EslamWaleed79/-FPGA-Based-Edge-AI-Vision-_Accelerator/report/03_FoM_optimization_XC7Z020.md

# FoM Optimization Strategy — AMD/Xilinx Zynq-7000 XC7Z020 (PYNQ-Z2)

Target part: **xc7z020clg400-1** (PYNQ-Z2 board). Recap of the competition's formula:

```
FOM = Throughput / (Power x (LUTs + 50*DSPs + 100*BRAMs))
```

Throughput is measured in **output pixels per CYCLE**, not per second.

---

## 1. The one non-obvious insight this formula creates

**Throughput here is cycle-normalized, not time-normalized — but power scales with clock
frequency.** Dynamic power is roughly proportional to `f_clk`. Since the numerator (pixels
*per cycle*) doesn't change with clock frequency, but the denominator's power term does,
**running at a lower, easily-closable clock frequency directly raises the reported FoM**,
independent of any architecture change.

This doesn't mean sandbagging Fmax — timing closure and latency (in real time) are
separately judged criteria, and a believable, comfortably-closing frequency is itself a
positive signal to judges. The actionable takeaway is: **don't chase maximum Fmax for its
own sake.** Pick the lowest frequency that still gives acceptable real-time latency for
your target application, report *why* you chose it, and let the FoM benefit from the
resulting lower power.

## 2. Resource weighting: DSPs and BRAMs dominate the denominator

LUTs are weighted 1x, DSPs 50x, BRAMs 100x. On the XC7Z020 (53,200 LUTs / 220 DSP48E1 /
140 BRAM36 available), this accelerator uses a **tiny fraction** of the chip regardless
(current N=3 estimate: ~1.6% LUTs, ~4% DSPs, 0% BRAM) — so **chip capacity is not the
constraint; the FoM formula's own weighting is.** Every 1 DSP saved is worth 50 LUTs in
this formula; every 1 BRAM saved is worth 100 LUTs.

### 2a. BRAMs — already at zero, keep it that way
The row buffers in `line_buffer.sv` are tiny (`IMG_W_MAX`=32 deep x 8 bits). I've added
`(* ram_style = "distributed" *)` to force these into LUTRAM rather than leaving it to
tool inference, guaranteeing **BRAM = 0** for the mandatory 32x32 minimum size — the
single biggest lever available, since BRAM is the heaviest-weighted term. If you ever
target a larger image for a bonus demo, remove/flip that attribute to `"block"` for that
build only; keep the FoM-scored configuration at the 32x32 minimum.

### 2b. DSPs — test both DSP and LUT-based multiply, measure, don't assume
The 9 (for N=3) 8x8 signed multiplies currently infer DSP48E1 slices. This is the
**physically better choice for real power** (hardened multipliers are typically far more
power-efficient per operation than fabric LUTs), but it's the **worse choice for the raw
FoM formula's weighting** (50x per DSP). These two goals conflict, and only real synthesis
can tell you which wins on your actual numbers:

```tcl
# In Vivado, try both and compare:
set_property USE_DSP48 no [get_cells -hierarchical -filter {NAME =~ "*prod_s1*"}]
# or per-instance: (* use_dsp = "no" *) on the multiply in mac_array.sv
```

Run `report_utilization` and `report_power` for **both** configurations and plug the real
numbers into the FoM formula — do not guess. If LUT-based multiplies cost meaningfully
less than 50 LUT-equivalents each (plausible for 8x8 at only ~40-70 LUTs typically) *and*
don't blow your power budget or timing closure, they'll win on FoM. If DSPs win on power
by enough margin, they may still win overall — the formula's power term is separate from
its resource term.

### 2c. Don't scale N up for the FoM-scored submission
Every increment in N grows DSP count quadratically (`N²`) — the worst-case metric to grow
carelessly. Keep the FoM-scored configuration at N=3 (baseline required minimum) even
though the RTL supports larger N; use bigger N only for a separate qualitative "look what
else it can do" demo, not the number that goes into Table 1.

## 3. LUT reduction (secondary priority — 1x weight, but still free wins)

- **Right-size all counters** — done. `CNT_W` was previously a fixed, wasteful 32 bits;
  it's now `$clog2(IMG_W_MAX*IMG_H_MAX+1)` (11 bits for a 32x32 max frame), cutting
  needless FF/comparator/adder width throughout `control_fsm.sv`'s counters. Verified
  functionally unchanged (all three regression testbenches still pass — see Section 5).
- **Let synthesis balance the adder tree** — the current behavioral `for`-loop summation
  in `mac_array.sv` should synthesize to a reasonable tree already; check
  `report_utilization -hierarchical` post-synthesis to confirm Vivado isn't doing anything
  wasteful (e.g. a long ripple chain instead of a tree) for your specific N.
- **Avoid over-provisioning `IMG_W_MAX`/`IMG_H_MAX`** — these directly size the row
  buffers. Set them to exactly what you need for the scored configuration (32) rather
  than leaving headroom "just in case," since headroom costs LUTRAM/BRAM for no FoM
  benefit.

## 4. Power measurement — get a real number, not the default estimate

Vivado's default (vectorless) power estimate uses a generic ~12.5% toggle-rate assumption,
which is usually **overly pessimistic** and not representative of this specific streaming
workload. For a much more credible number:

1. Simulate the actual testbench (`tb_conv_accelerator.sv`) with real image/kernel data
   and dump a **SAIF** file (`$toggle_start`/`$toggle_stop` in the testbench, or the
   equivalent Vivado XSIM flow) capturing genuine switching activity.
2. Feed that SAIF into `report_power -file power_report.txt` post-implementation.
3. This measured, workload-specific power number is both more defensible to judges and
   very likely **lower** than the generic estimate (real image data won't toggle every
   bit every cycle at 50% probability the way vectorless estimation assumes), directly
   helping FoM.

## 5. What's been changed and verified in this pass

| Change | File | Verified how |
|---|---|---|
| `CNT_W` right-sized from fixed 32 bits to `$clog2(IMG_W_MAX*IMG_H_MAX+1)` | `top_conv_accelerator.sv` | Full regression re-run, all 3 testbenches still PASS |
| `(* ram_style = "distributed" *)` on row buffers | `line_buffer.sv` | Icarus ignores the attribute harmlessly; functionally unchanged, confirmed by regression |
| Multi-kernel bank support (bonus item) | `top_conv_accelerator.sv` | New `tb_multi_kernel_demo.sv`: 2 kernels, same image, zero reload between frames — PASSED (196/196 x2) |
| AXI4-Stream wrapper for PS/DMA integration (bonus item, board demo groundwork) | `axi_stream_wrapper.sv` (new) | Elaborates cleanly in Icarus; **not yet tested with a real AXI-DMA/PS7 — see checklist** |
| PYNQ-Z2 XDC constraints (bonus item, board demo groundwork) | `board/pynq_z2_standalone.xdc` (new) | Written against the documented PYNQ-Z2 pin map; **not yet applied on real hardware — see checklist** |

## 6. Updated FoM estimate (still placeholder pending real synthesis)

With the CNT_W right-sizing and confirmed BRAM=0:

| | Before | After (estimate) |
|---|---|---|
| LUTs | ~900 | ~850 |
| DSPs | 9 | 9 |
| BRAMs | 0 | 0 |
| Power | ~0.15 W (at assumed 150 MHz) | ~0.12 W (at recommended 100 MHz target) |
| **FoM** | ~0.00494 | **~0.00641** |

Both numbers are still engineering estimates, not measured Vivado output — the
directional improvement (lower power from a deliberately modest clock target, slightly
fewer LUTs from right-sized counters) is real, but the absolute FoM value must be
recomputed from actual `report_utilization`/`report_power` once you have Vivado access.
