EslamWaleed79/-FPGA-Based-Edge-AI-Vision-_Accelerator/Vivado_____Files/Run1/project_3.runs/design_1_axi_dma_0_0_synth_1/.vivado.begin.rst

<?xml version="1.0"?>
<ProcessHandle Version="1" Minor="0">
    <Process Command="vivado.bat" Owner="compumarts" Host="DESKTOP-1IDCUPR" Pid="28528">
    </Process>
</ProcessHandle>
