EslamWaleed79/-FPGA-Based-Edge-AI-Vision-_Accelerator/Vivado_____Files/Run1/project_3.runs/impl_1/.init_design.begin.rst

<?xml version="1.0"?>
<ProcessHandle Version="1" Minor="0">
    <Process Command=".planAhead." Owner="compumarts" Host="DESKTOP-1IDCUPR" Pid="28092">
    </Process>
</ProcessHandle>
