EslamWaleed79/-FPGA-Based-Edge-AI-Vision-_Accelerator/Vivado_Reports/post_route_power_report.txt

Copyright 1986-2018 Xilinx, Inc. All Rights Reserved.
----------------------------------------------------------------------------------------
| Tool Version     : Vivado v.2018.2 (win64) Build 2258646 Thu Jun 14 20:03:12 MDT 2018
| Date             : Wed Sep  9 02:31:31 2026
| Host             : DESKTOP-1IDCUPR running 64-bit major release  (build 9200)
| Command          : report_power -file post_route_power_report.txt
| Design           : top_conv_accelerator
| Device           : xc7z020clg400-1
| Design State     : routed
| Grade            : commercial
| Process          : typical
| Characterization : Production
----------------------------------------------------------------------------------------

Power Report

Table of Contents
-----------------
1. Summary
1.1 On-Chip Components
1.2 Power Supply Summary
1.3 Confidence Level
2. Settings
2.1 Environment
2.2 Clock Constraints
3. Detailed Reports
3.1 By Hierarchy

1. Summary
----------

+--------------------------+----------------------------------------------------------------------------------------------+
| Total On-Chip Power (W)  | 0.125                                                                                        |
| Design Power Budget (W)  | Unspecified*                                                                                 |
| Power Budget Margin (W)  | NA                                                                                           |
| Dynamic (W)              | 0.020                                                                                        |
| Device Static (W)        | 0.105                                                                                        |
| Effective TJA (C/W)      | 11.5                                                                                         |
| Max Ambient (C)          | 83.6                                                                                         |
| Junction Temperature (C) | 26.4                                                                                         |
| Confidence Level         | Medium                                                                                       |
| Setting File             | ---                                                                                          |
| Simulation Activity File | C:/Users/compumarts/Desktop/project_2/project_2.sim/sim_1/impl/func/xsim/activity_final.saif |
| Design Nets Matched      | 2%   (64/3500)                                                                               |
+--------------------------+----------------------------------------------------------------------------------------------+
* Specify Design Power Budget using, set_operating_conditions -design_power_budget <value in Watts>

1.1 On-Chip Components
----------------------

+-------------------------+-----------+----------+-----------+-----------------+
| On-Chip                 | Power (W) | Used     | Available | Utilization (%) |
+-------------------------+-----------+----------+-----------+-----------------+
| Clocks                  |     0.003 |        3 |       --- |             --- |
| Slice Logic             |     0.005 |     2929 |       --- |             --- |
|   LUT as Logic          |     0.004 |     1231 |     53200 |            2.31 |
|   CARRY4                |    <0.001 |      154 |     13300 |            1.16 |
|   Register              |    <0.001 |     1106 |    106400 |            1.04 |
|   F7/F8 Muxes           |    <0.001 |       64 |     53200 |            0.12 |
|   LUT as Shift Register |    <0.001 |        1 |     17400 |           <0.01 |
|   Others                |     0.000 |        9 |       --- |             --- |
| Signals                 |     0.005 |     2482 |       --- |             --- |
| I/O                     |     0.007 |       62 |       125 |           49.60 |
| Static Power            |     0.105 |          |           |                 |
| Total                   |     0.125 |          |           |                 |
+-------------------------+-----------+----------+-----------+-----------------+

1.2 Power Supply Summary
------------------------

+-----------+-------------+-----------+-------------+------------+
| Source    | Voltage (V) | Total (A) | Dynamic (A) | Static (A) |
+-----------+-------------+-----------+-------------+------------+
| Vccint    |       1.000 |     0.020 |       0.013 |      0.007 |
| Vccaux    |       1.800 |     0.011 |       0.001 |      0.010 |
| Vcco33    |       3.300 |     0.000 |       0.000 |      0.000 |
| Vcco25    |       2.500 |     0.000 |       0.000 |      0.000 |
| Vcco18    |       1.800 |     0.004 |       0.003 |      0.001 |
| Vcco15    |       1.500 |     0.000 |       0.000 |      0.000 |
| Vcco135   |       1.350 |     0.000 |       0.000 |      0.000 |
| Vcco12    |       1.200 |     0.000 |       0.000 |      0.000 |
| Vccaux_io |       1.800 |     0.000 |       0.000 |      0.000 |
| Vccbram   |       1.000 |     0.000 |       0.000 |      0.000 |
| MGTAVcc   |       1.000 |     0.000 |       0.000 |      0.000 |
| MGTAVtt   |       1.200 |     0.000 |       0.000 |      0.000 |
| MGTVccaux |       1.800 |     0.000 |       0.000 |      0.000 |
| Vccpint   |       1.000 |     0.016 |       0.000 |      0.016 |
| Vccpaux   |       1.800 |     0.010 |       0.000 |      0.010 |
| Vccpll    |       1.800 |     0.003 |       0.000 |      0.003 |
| Vcco_ddr  |       1.500 |     0.000 |       0.000 |      0.000 |
| Vcco_mio0 |       1.800 |     0.000 |       0.000 |      0.000 |
| Vcco_mio1 |       1.800 |     0.000 |       0.000 |      0.000 |
| Vccadc    |       1.800 |     0.020 |       0.000 |      0.020 |
+-----------+-------------+-----------+-------------+------------+

1.3 Confidence Level
--------------------

+-----------------------------+------------+------------------------------------------------+------------------------------------------------------------------------------------------------------------+
| User Input Data             | Confidence | Details                                        | Action                                                                                                     |
+-----------------------------+------------+------------------------------------------------+------------------------------------------------------------------------------------------------------------+
| Design implementation state | High       | Design is routed                               |                                                                                                            |
| Clock nodes activity        | High       | User specified more than 95% of clocks         |                                                                                                            |
| I/O nodes activity          | High       | User specified more than 95% of inputs         |                                                                                                            |
| Internal nodes activity     | Medium     | User specified less than 25% of internal nodes | Provide missing internal nodes activity with simulation results or by editing the "By Resource Type" views |
| Device models               | High       | Device models are Production                   |                                                                                                            |
|                             |            |                                                |                                                                                                            |
| Overall confidence level    | Medium     |                                                |                                                                                                            |
+-----------------------------+------------+------------------------------------------------+------------------------------------------------------------------------------------------------------------+

2. Settings
-----------

2.1 Environment
---------------

+-----------------------+------------------------+
| Ambient Temp (C)      | 25.0                   |
| ThetaJA (C/W)         | 11.5                   |
| Airflow (LFM)         | 250                    |
| Heat Sink             | none                   |
| ThetaSA (C/W)         | 0.0                    |
| Board Selection       | medium (10"x10")       |
| # of Board Layers     | 8to11 (8 to 11 Layers) |
| Board Temperature (C) | 25.0                   |
+-----------------------+------------------------+

2.2 Clock Constraints
---------------------

+-------+--------+-----------------+
| Clock | Domain | Constraint (ns) |
+-------+--------+-----------------+
| clk   | clk    |            15.0 |
+-------+--------+-----------------+

3. Detailed Reports
-------------------

3.1 By Hierarchy
----------------

+----------------------+-----------+
| Name                 | Power (W) |
+----------------------+-----------+
| top_conv_accelerator |     0.020 |
|   u_fsm              |    <0.001 |
|   u_line_buffer      |     0.005 |
|   u_mac_array        |     0.006 |
|     u_relu           |    <0.001 |
+----------------------+-----------+
