EslamWaleed79/-FPGA-Based-Edge-AI-Vision-_Accelerator/edge_demo/edge_detection_result.png

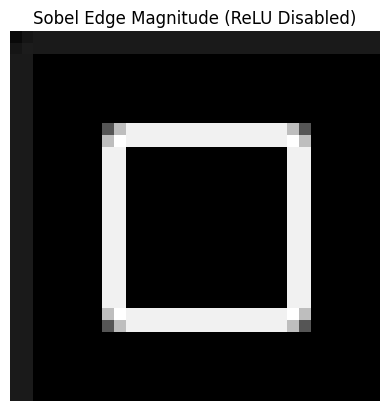
edge_demo/edge_detection_result.png
