EslamWaleed79/-FPGA-Based-Edge-AI-Vision-_Accelerator/FPGA Demo Files/test.jpg

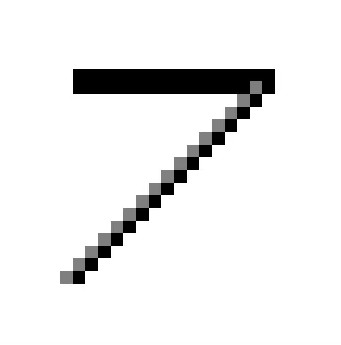
FPGA Demo Files/test.jpg
