EslamWaleed79/-FPGA-Based-Edge-AI-Vision-_Accelerator/Vivado_____Files/Run1/project_3.runs/design_1_axi_smc_0_synth_1/.Xil/design_1_axi_smc_0_propImpl.xdc

set_property SRC_FILE_INFO {cfile:C:/Xilinx/Vivado/2018.2/data/ip/xpm/xpm_memory/tcl/xpm_memory_xdc.tcl rfile:../../../../../../../Xilinx/Vivado/2018.2/data/ip/xpm/xpm_memory/tcl/xpm_memory_xdc.tcl id:1 order:LATE scoped_inst:{inst/m00_nodes/m00_ar_node/inst/inst_mi_handler/gen_normal_area.gen_node_prog_full.inst_node_prog_full/gen_xpm_memory_fifo.inst_fifo/gen_mem_rep[0].inst_xpm_memory} unmanaged:yes} [current_design]
set_property SRC_FILE_INFO {cfile:C:/Xilinx/Vivado/2018.2/data/ip/xpm/xpm_memory/tcl/xpm_memory_xdc.tcl rfile:../../../../../../../Xilinx/Vivado/2018.2/data/ip/xpm/xpm_memory/tcl/xpm_memory_xdc.tcl id:2 order:LATE scoped_inst:{inst/m00_nodes/m00_aw_node/inst/inst_mi_handler/gen_normal_area.gen_node_prog_full.inst_node_prog_full/gen_xpm_memory_fifo.inst_fifo/gen_mem_rep[0].inst_xpm_memory} unmanaged:yes} [current_design]
set_property SRC_FILE_INFO {cfile:C:/Xilinx/Vivado/2018.2/data/ip/xpm/xpm_memory/tcl/xpm_memory_xdc.tcl rfile:../../../../../../../Xilinx/Vivado/2018.2/data/ip/xpm/xpm_memory/tcl/xpm_memory_xdc.tcl id:3 order:LATE scoped_inst:{inst/m00_nodes/m00_w_node/inst/inst_mi_handler/gen_normal_area.gen_node_prog_full.inst_node_prog_full/gen_xpm_memory_fifo.inst_fifo/gen_mem_rep[0].inst_xpm_memory} unmanaged:yes} [current_design]
set_property SRC_FILE_INFO {cfile:C:/Xilinx/Vivado/2018.2/data/ip/xpm/xpm_memory/tcl/xpm_memory_xdc.tcl rfile:../../../../../../../Xilinx/Vivado/2018.2/data/ip/xpm/xpm_memory/tcl/xpm_memory_xdc.tcl id:4 order:LATE scoped_inst:{inst/s00_nodes/s00_r_node/inst/inst_mi_handler/gen_normal_area.gen_node_prog_full.inst_node_prog_full/gen_xpm_memory_fifo.inst_fifo/gen_mem_rep[0].inst_xpm_memory} unmanaged:yes} [current_design]
set_property SRC_FILE_INFO {cfile:C:/Xilinx/Vivado/2018.2/data/ip/xpm/xpm_memory/tcl/xpm_memory_xdc.tcl rfile:../../../../../../../Xilinx/Vivado/2018.2/data/ip/xpm/xpm_memory/tcl/xpm_memory_xdc.tcl id:5 order:LATE scoped_inst:{inst/s01_nodes/s01_b_node/inst/inst_mi_handler/gen_normal_area.gen_node_prog_full.inst_node_prog_full/gen_xpm_memory_fifo.inst_fifo/gen_mem_rep[0].inst_xpm_memory} unmanaged:yes} [current_design]
set_property SRC_FILE_INFO {cfile:C:/Xilinx/Vivado/2018.2/data/ip/xpm/xpm_memory/tcl/xpm_memory_xdc.tcl rfile:../../../../../../../Xilinx/Vivado/2018.2/data/ip/xpm/xpm_memory/tcl/xpm_memory_xdc.tcl id:6 order:LATE scoped_inst:{inst/m00_nodes/m00_ar_node/inst/inst_mi_handler/gen_normal_area.inst_fifo_node_payld/gen_xpm_memory_fifo.inst_fifo/gen_mem_rep[0].inst_xpm_memory} unmanaged:yes} [current_design]
set_property SRC_FILE_INFO {cfile:C:/Xilinx/Vivado/2018.2/data/ip/xpm/xpm_memory/tcl/xpm_memory_xdc.tcl rfile:../../../../../../../Xilinx/Vivado/2018.2/data/ip/xpm/xpm_memory/tcl/xpm_memory_xdc.tcl id:7 order:LATE scoped_inst:{inst/m00_nodes/m00_aw_node/inst/inst_mi_handler/gen_normal_area.inst_fifo_node_payld/gen_xpm_memory_fifo.inst_fifo/gen_mem_rep[0].inst_xpm_memory} unmanaged:yes} [current_design]
set_property SRC_FILE_INFO {cfile:C:/Xilinx/Vivado/2018.2/data/ip/xpm/xpm_memory/tcl/xpm_memory_xdc.tcl rfile:../../../../../../../Xilinx/Vivado/2018.2/data/ip/xpm/xpm_memory/tcl/xpm_memory_xdc.tcl id:8 order:LATE scoped_inst:{inst/m00_nodes/m00_b_node/inst/inst_mi_handler/gen_normal_area.gen_fifo_req.inst_fifo_req/gen_xpm_memory_fifo.inst_fifo/gen_mem_rep[0].inst_xpm_memory} unmanaged:yes} [current_design]
set_property SRC_FILE_INFO {cfile:C:/Xilinx/Vivado/2018.2/data/ip/xpm/xpm_memory/tcl/xpm_memory_xdc.tcl rfile:../../../../../../../Xilinx/Vivado/2018.2/data/ip/xpm/xpm_memory/tcl/xpm_memory_xdc.tcl id:9 order:LATE scoped_inst:{inst/m00_nodes/m00_r_node/inst/inst_mi_handler/gen_normal_area.gen_fifo_req.inst_fifo_req/gen_xpm_memory_fifo.inst_fifo/gen_mem_rep[0].inst_xpm_memory} unmanaged:yes} [current_design]
set_property SRC_FILE_INFO {cfile:C:/Xilinx/Vivado/2018.2/data/ip/xpm/xpm_memory/tcl/xpm_memory_xdc.tcl rfile:../../../../../../../Xilinx/Vivado/2018.2/data/ip/xpm/xpm_memory/tcl/xpm_memory_xdc.tcl id:10 order:LATE scoped_inst:{inst/s01_nodes/s01_w_node/inst/inst_mi_handler/gen_normal_area.inst_fifo_node_payld/gen_xpm_memory_fifo.inst_fifo/gen_mem_rep[0].inst_xpm_memory} unmanaged:yes} [current_design]
set_property SRC_FILE_INFO {cfile:C:/Xilinx/Vivado/2018.2/data/ip/xpm/xpm_memory/tcl/xpm_memory_xdc.tcl rfile:../../../../../../../Xilinx/Vivado/2018.2/data/ip/xpm/xpm_memory/tcl/xpm_memory_xdc.tcl id:11 order:LATE scoped_inst:{inst/m00_nodes/m00_b_node/inst/inst_mi_handler/gen_normal_area.inst_fifo_node_payld/gen_xpm_memory_fifo.inst_fifo/gen_mem_rep[0].inst_xpm_memory} unmanaged:yes} [current_design]
set_property SRC_FILE_INFO {cfile:C:/Xilinx/Vivado/2018.2/data/ip/xpm/xpm_memory/tcl/xpm_memory_xdc.tcl rfile:../../../../../../../Xilinx/Vivado/2018.2/data/ip/xpm/xpm_memory/tcl/xpm_memory_xdc.tcl id:12 order:LATE scoped_inst:{inst/m00_nodes/m00_r_node/inst/inst_mi_handler/gen_normal_area.inst_fifo_node_payld/gen_xpm_memory_fifo.inst_fifo/gen_mem_rep[0].inst_xpm_memory} unmanaged:yes} [current_design]
set_property SRC_FILE_INFO {cfile:C:/Xilinx/Vivado/2018.2/data/ip/xpm/xpm_memory/tcl/xpm_memory_xdc.tcl rfile:../../../../../../../Xilinx/Vivado/2018.2/data/ip/xpm/xpm_memory/tcl/xpm_memory_xdc.tcl id:13 order:LATE scoped_inst:{inst/m00_nodes/m00_w_node/inst/inst_si_handler/gen_si_handler.gen_request_fifos.gen_req_fifo[0].inst_req_fifo/gen_xpm_memory_fifo.inst_fifo/gen_mem_rep[0].inst_xpm_memory} unmanaged:yes} [current_design]
set_property SRC_FILE_INFO {cfile:C:/Xilinx/Vivado/2018.2/data/ip/xpm/xpm_memory/tcl/xpm_memory_xdc.tcl rfile:../../../../../../../Xilinx/Vivado/2018.2/data/ip/xpm/xpm_memory/tcl/xpm_memory_xdc.tcl id:14 order:LATE scoped_inst:{inst/m00_nodes/m00_w_node/inst/inst_si_handler/gen_si_handler.gen_request_fifos.gen_req_fifo[1].inst_req_fifo/gen_xpm_memory_fifo.inst_fifo/gen_mem_rep[0].inst_xpm_memory} unmanaged:yes} [current_design]
set_property SRC_FILE_INFO {cfile:C:/Xilinx/Vivado/2018.2/data/ip/xpm/xpm_memory/tcl/xpm_memory_xdc.tcl rfile:../../../../../../../Xilinx/Vivado/2018.2/data/ip/xpm/xpm_memory/tcl/xpm_memory_xdc.tcl id:15 order:LATE scoped_inst:{inst/m00_nodes/m00_w_node/inst/inst_mi_handler/gen_normal_area.inst_fifo_node_payld/gen_xpm_memory_fifo.inst_fifo/gen_mem_rep[0].inst_xpm_memory} unmanaged:yes} [current_design]
set_property SRC_FILE_INFO {cfile:C:/Xilinx/Vivado/2018.2/data/ip/xpm/xpm_memory/tcl/xpm_memory_xdc.tcl rfile:../../../../../../../Xilinx/Vivado/2018.2/data/ip/xpm/xpm_memory/tcl/xpm_memory_xdc.tcl id:16 order:LATE scoped_inst:{inst/s00_nodes/s00_ar_node/inst/inst_mi_handler/gen_normal_area.gen_fifo_req.inst_fifo_req/gen_xpm_memory_fifo.inst_fifo/gen_mem_rep[0].inst_xpm_memory} unmanaged:yes} [current_design]
set_property SRC_FILE_INFO {cfile:C:/Xilinx/Vivado/2018.2/data/ip/xpm/xpm_memory/tcl/xpm_memory_xdc.tcl rfile:../../../../../../../Xilinx/Vivado/2018.2/data/ip/xpm/xpm_memory/tcl/xpm_memory_xdc.tcl id:17 order:LATE scoped_inst:{inst/s01_nodes/s01_aw_node/inst/inst_mi_handler/gen_normal_area.gen_fifo_req.inst_fifo_req/gen_xpm_memory_fifo.inst_fifo/gen_mem_rep[0].inst_xpm_memory} unmanaged:yes} [current_design]
set_property SRC_FILE_INFO {cfile:C:/Xilinx/Vivado/2018.2/data/ip/xpm/xpm_memory/tcl/xpm_memory_xdc.tcl rfile:../../../../../../../Xilinx/Vivado/2018.2/data/ip/xpm/xpm_memory/tcl/xpm_memory_xdc.tcl id:18 order:LATE scoped_inst:{inst/s01_nodes/s01_w_node/inst/inst_mi_handler/gen_normal_area.gen_fifo_req.inst_fifo_req/gen_xpm_memory_fifo.inst_fifo/gen_mem_rep[0].inst_xpm_memory} unmanaged:yes} [current_design]
set_property SRC_FILE_INFO {cfile:C:/Xilinx/Vivado/2018.2/data/ip/xpm/xpm_memory/tcl/xpm_memory_xdc.tcl rfile:../../../../../../../Xilinx/Vivado/2018.2/data/ip/xpm/xpm_memory/tcl/xpm_memory_xdc.tcl id:19 order:LATE scoped_inst:{inst/s00_nodes/s00_ar_node/inst/inst_mi_handler/gen_normal_area.inst_fifo_node_payld/gen_xpm_memory_fifo.inst_fifo/gen_mem_rep[0].inst_xpm_memory} unmanaged:yes} [current_design]
set_property SRC_FILE_INFO {cfile:C:/Xilinx/Vivado/2018.2/data/ip/xpm/xpm_memory/tcl/xpm_memory_xdc.tcl rfile:../../../../../../../Xilinx/Vivado/2018.2/data/ip/xpm/xpm_memory/tcl/xpm_memory_xdc.tcl id:20 order:LATE scoped_inst:{inst/s01_nodes/s01_aw_node/inst/inst_mi_handler/gen_normal_area.inst_fifo_node_payld/gen_xpm_memory_fifo.inst_fifo/gen_mem_rep[0].inst_xpm_memory} unmanaged:yes} [current_design]
set_property SRC_FILE_INFO {cfile:C:/Xilinx/Vivado/2018.2/data/ip/xpm/xpm_memory/tcl/xpm_memory_xdc.tcl rfile:../../../../../../../Xilinx/Vivado/2018.2/data/ip/xpm/xpm_memory/tcl/xpm_memory_xdc.tcl id:21 order:LATE scoped_inst:{inst/s00_nodes/s00_r_node/inst/inst_mi_handler/gen_normal_area.inst_fifo_node_payld/gen_xpm_memory_fifo.inst_fifo/gen_mem_rep[0].inst_xpm_memory} unmanaged:yes} [current_design]
set_property SRC_FILE_INFO {cfile:C:/Xilinx/Vivado/2018.2/data/ip/xpm/xpm_memory/tcl/xpm_memory_xdc.tcl rfile:../../../../../../../Xilinx/Vivado/2018.2/data/ip/xpm/xpm_memory/tcl/xpm_memory_xdc.tcl id:22 order:LATE scoped_inst:{inst/s01_nodes/s01_b_node/inst/inst_mi_handler/gen_normal_area.inst_fifo_node_payld/gen_xpm_memory_fifo.inst_fifo/gen_mem_rep[0].inst_xpm_memory} unmanaged:yes} [current_design]
set_property src_info {type:SCOPED_XDC file:1 line:3 export:INPUT save:NONE read:READ} [current_design]
set my_var [get_property dram_emb_xdc [get_cells -hier  -filter {PRIMITIVE_SUBGROUP==LUTRAM || PRIMITIVE_SUBGROUP==dram || PRIMITIVE_SUBGROUP==uram || PRIMITIVE_SUBGROUP==BRAM}]]
set_property src_info {type:SCOPED_XDC file:2 line:3 export:INPUT save:NONE read:READ} [current_design]
set my_var [get_property dram_emb_xdc [get_cells -hier  -filter {PRIMITIVE_SUBGROUP==LUTRAM || PRIMITIVE_SUBGROUP==dram || PRIMITIVE_SUBGROUP==uram || PRIMITIVE_SUBGROUP==BRAM}]]
set_property src_info {type:SCOPED_XDC file:3 line:3 export:INPUT save:NONE read:READ} [current_design]
set my_var [get_property dram_emb_xdc [get_cells -hier  -filter {PRIMITIVE_SUBGROUP==LUTRAM || PRIMITIVE_SUBGROUP==dram || PRIMITIVE_SUBGROUP==uram || PRIMITIVE_SUBGROUP==BRAM}]]
set_property src_info {type:SCOPED_XDC file:4 line:3 export:INPUT save:NONE read:READ} [current_design]
set my_var [get_property dram_emb_xdc [get_cells -hier  -filter {PRIMITIVE_SUBGROUP==LUTRAM || PRIMITIVE_SUBGROUP==dram || PRIMITIVE_SUBGROUP==uram || PRIMITIVE_SUBGROUP==BRAM}]]
set_property src_info {type:SCOPED_XDC file:5 line:3 export:INPUT save:NONE read:READ} [current_design]
set my_var [get_property dram_emb_xdc [get_cells -hier  -filter {PRIMITIVE_SUBGROUP==LUTRAM || PRIMITIVE_SUBGROUP==dram || PRIMITIVE_SUBGROUP==uram || PRIMITIVE_SUBGROUP==BRAM}]]
set_property src_info {type:SCOPED_XDC file:6 line:3 export:INPUT save:NONE read:READ} [current_design]
set my_var [get_property dram_emb_xdc [get_cells -hier  -filter {PRIMITIVE_SUBGROUP==LUTRAM || PRIMITIVE_SUBGROUP==dram || PRIMITIVE_SUBGROUP==uram || PRIMITIVE_SUBGROUP==BRAM}]]
set_property src_info {type:SCOPED_XDC file:7 line:3 export:INPUT save:NONE read:READ} [current_design]
set my_var [get_property dram_emb_xdc [get_cells -hier  -filter {PRIMITIVE_SUBGROUP==LUTRAM || PRIMITIVE_SUBGROUP==dram || PRIMITIVE_SUBGROUP==uram || PRIMITIVE_SUBGROUP==BRAM}]]
set_property src_info {type:SCOPED_XDC file:8 line:3 export:INPUT save:NONE read:READ} [current_design]
set my_var [get_property dram_emb_xdc [get_cells -hier  -filter {PRIMITIVE_SUBGROUP==LUTRAM || PRIMITIVE_SUBGROUP==dram || PRIMITIVE_SUBGROUP==uram || PRIMITIVE_SUBGROUP==BRAM}]]
set_property src_info {type:SCOPED_XDC file:9 line:3 export:INPUT save:NONE read:READ} [current_design]
set my_var [get_property dram_emb_xdc [get_cells -hier  -filter {PRIMITIVE_SUBGROUP==LUTRAM || PRIMITIVE_SUBGROUP==dram || PRIMITIVE_SUBGROUP==uram || PRIMITIVE_SUBGROUP==BRAM}]]
set_property src_info {type:SCOPED_XDC file:10 line:3 export:INPUT save:NONE read:READ} [current_design]
set my_var [get_property dram_emb_xdc [get_cells -hier  -filter {PRIMITIVE_SUBGROUP==LUTRAM || PRIMITIVE_SUBGROUP==dram || PRIMITIVE_SUBGROUP==uram || PRIMITIVE_SUBGROUP==BRAM}]]
set_property src_info {type:SCOPED_XDC file:11 line:3 export:INPUT save:NONE read:READ} [current_design]
set my_var [get_property dram_emb_xdc [get_cells -hier  -filter {PRIMITIVE_SUBGROUP==LUTRAM || PRIMITIVE_SUBGROUP==dram || PRIMITIVE_SUBGROUP==uram || PRIMITIVE_SUBGROUP==BRAM}]]
set_property src_info {type:SCOPED_XDC file:12 line:3 export:INPUT save:NONE read:READ} [current_design]
set my_var [get_property dram_emb_xdc [get_cells -hier  -filter {PRIMITIVE_SUBGROUP==LUTRAM || PRIMITIVE_SUBGROUP==dram || PRIMITIVE_SUBGROUP==uram || PRIMITIVE_SUBGROUP==BRAM}]]
set_property src_info {type:SCOPED_XDC file:13 line:3 export:INPUT save:NONE read:READ} [current_design]
set my_var [get_property dram_emb_xdc [get_cells -hier  -filter {PRIMITIVE_SUBGROUP==LUTRAM || PRIMITIVE_SUBGROUP==dram || PRIMITIVE_SUBGROUP==uram || PRIMITIVE_SUBGROUP==BRAM}]]
set_property src_info {type:SCOPED_XDC file:14 line:3 export:INPUT save:NONE read:READ} [current_design]
set my_var [get_property dram_emb_xdc [get_cells -hier  -filter {PRIMITIVE_SUBGROUP==LUTRAM || PRIMITIVE_SUBGROUP==dram || PRIMITIVE_SUBGROUP==uram || PRIMITIVE_SUBGROUP==BRAM}]]
set_property src_info {type:SCOPED_XDC file:15 line:3 export:INPUT save:NONE read:READ} [current_design]
set my_var [get_property dram_emb_xdc [get_cells -hier  -filter {PRIMITIVE_SUBGROUP==LUTRAM || PRIMITIVE_SUBGROUP==dram || PRIMITIVE_SUBGROUP==uram || PRIMITIVE_SUBGROUP==BRAM}]]
set_property src_info {type:SCOPED_XDC file:16 line:3 export:INPUT save:NONE read:READ} [current_design]
set my_var [get_property dram_emb_xdc [get_cells -hier  -filter {PRIMITIVE_SUBGROUP==LUTRAM || PRIMITIVE_SUBGROUP==dram || PRIMITIVE_SUBGROUP==uram || PRIMITIVE_SUBGROUP==BRAM}]]
set_property src_info {type:SCOPED_XDC file:17 line:3 export:INPUT save:NONE read:READ} [current_design]
set my_var [get_property dram_emb_xdc [get_cells -hier  -filter {PRIMITIVE_SUBGROUP==LUTRAM || PRIMITIVE_SUBGROUP==dram || PRIMITIVE_SUBGROUP==uram || PRIMITIVE_SUBGROUP==BRAM}]]
set_property src_info {type:SCOPED_XDC file:18 line:3 export:INPUT save:NONE read:READ} [current_design]
set my_var [get_property dram_emb_xdc [get_cells -hier  -filter {PRIMITIVE_SUBGROUP==LUTRAM || PRIMITIVE_SUBGROUP==dram || PRIMITIVE_SUBGROUP==uram || PRIMITIVE_SUBGROUP==BRAM}]]
set_property src_info {type:SCOPED_XDC file:19 line:3 export:INPUT save:NONE read:READ} [current_design]
set my_var [get_property dram_emb_xdc [get_cells -hier  -filter {PRIMITIVE_SUBGROUP==LUTRAM || PRIMITIVE_SUBGROUP==dram || PRIMITIVE_SUBGROUP==uram || PRIMITIVE_SUBGROUP==BRAM}]]
set_property src_info {type:SCOPED_XDC file:20 line:3 export:INPUT save:NONE read:READ} [current_design]
set my_var [get_property dram_emb_xdc [get_cells -hier  -filter {PRIMITIVE_SUBGROUP==LUTRAM || PRIMITIVE_SUBGROUP==dram || PRIMITIVE_SUBGROUP==uram || PRIMITIVE_SUBGROUP==BRAM}]]
set_property src_info {type:SCOPED_XDC file:21 line:3 export:INPUT save:NONE read:READ} [current_design]
set my_var [get_property dram_emb_xdc [get_cells -hier  -filter {PRIMITIVE_SUBGROUP==LUTRAM || PRIMITIVE_SUBGROUP==dram || PRIMITIVE_SUBGROUP==uram || PRIMITIVE_SUBGROUP==BRAM}]]
set_property src_info {type:SCOPED_XDC file:22 line:3 export:INPUT save:NONE read:READ} [current_design]
set my_var [get_property dram_emb_xdc [get_cells -hier  -filter {PRIMITIVE_SUBGROUP==LUTRAM || PRIMITIVE_SUBGROUP==dram || PRIMITIVE_SUBGROUP==uram || PRIMITIVE_SUBGROUP==BRAM}]]
