EslamWaleed79/-FPGA-Based-Edge-AI-Vision-_Accelerator/Vivado_____Files/Run1/project_3.srcs/Users/compumarts/Desktop/project_2/project_2.srcs/sources_1/imports/Desktop/project_1/rtl/control_fsm.sv

// =============================================================================
// control_fsm.sv
// -----------------------------------------------------------------------------
// Top-level sequencing FSM for the NxN convolution accelerator.
//
// States:
//   IDLE        - waiting for 'start'. Kernel coefficients are assumed to be
//                 loaded (via the always-available kernel config port on the
//                 top level) before or during IDLE; they must be stable by
//                 the time RUN begins.
//   LOAD        - one-cycle bridge state that clears the line buffer / pixel
//                 counters for a new frame (asserts 'frame_clear').
//   RUN         - streaming state: accepts one input pixel per cycle
//                 (in_ready=1), counts pixels accepted (pix_cnt) and valid
//                 output pixels produced (out_cnt). This is the state that
//                 delivers the 1-pixel/cycle throughput bonus target.
//   DRAIN       - all IMG_H*IMG_W input pixels have been accepted; no more
//                 pixels are pushed in, but the datapath pipeline (line
//                 buffer latency + MAC pipeline latency) still has valid
//                 output pixels "in flight". DRAIN waits until out_cnt
//                 reaches the expected total output count.
//   DONE        - asserts 'done' for one cycle, then returns to IDLE.
//
// out_total = (IMG_H - N + 1) * (IMG_W - N + 1)   (computed by the caller /
//   top level and passed in as 'cfg_out_total', since multiply-by-runtime-
//   value is cheap to do once outside the FSM's critical path).
// =============================================================================

module control_fsm #(
    parameter int CNT_W = 32
) (
    input  logic              clk,
    input  logic              rst_n,

    input  logic               start,           // pulse: begin a new frame
    input  logic [CNT_W-1:0]   cfg_pix_total,    // IMG_H * IMG_W (total input pixels)
    input  logic [CNT_W-1:0]   cfg_out_total,    // (IMG_H-N+1)*(IMG_W-N+1) (total valid outputs)

    input  logic               out_valid_pulse,  // pulses once per valid output pixel from mac_array

    output logic               frame_clear,      // 1-cycle pulse: clear line buffer state
    output logic               in_ready,         // 1 while FSM is in RUN (may accept in_valid)
    output logic               busy,
    output logic               done              // 1-cycle pulse when the frame is complete
);

    typedef enum logic [2:0] {S_IDLE, S_LOAD, S_RUN, S_DRAIN, S_DONE} state_t;
    state_t state, state_n;

    logic [CNT_W-1:0] out_cnt, out_cnt_n;

    always_ff @(posedge clk or negedge rst_n) begin
        if (!rst_n) begin
            state   <= S_IDLE;
            out_cnt <= '0;
        end else begin
            state   <= state_n;
            out_cnt <= out_cnt_n;
        end
    end

    always_comb begin
        state_n     = state;
        out_cnt_n   = out_cnt;
        frame_clear = 1'b0;
        in_ready    = 1'b0;
        busy        = 1'b1;
        done        = 1'b0;

        unique case (state)
            S_IDLE: begin
                busy = 1'b0;
                if (start) state_n = S_LOAD;
            end

            S_LOAD: begin
                frame_clear = 1'b1;
                out_cnt_n   = '0;
                state_n     = S_RUN;
            end

            S_RUN: begin
                in_ready = 1'b1;
                if (out_valid_pulse)
                    out_cnt_n = out_cnt + 1'b1;
                // Move to DRAIN once every output has arrived even before all
                // inputs technically finish issuing (edge case for very small
                // frames); primary transition is driven by the top level
                // de-asserting in_valid after cfg_pix_total pixels, handled
                // by the top-level pixel counter instead (kept out of this
                // FSM to keep it purely output-count driven and reusable).
                if (out_cnt_n == cfg_out_total)
                    state_n = S_DONE;
                else if (!out_valid_pulse && out_cnt == cfg_out_total)
                    state_n = S_DONE;
            end

            S_DRAIN: begin
                // Reserved state for architectures where input acceptance
                // must stop strictly before output count is known (kept for
                // clarity / future flow-controlled variants). Current design
                // resolves completion directly from S_RUN via out_cnt.
                if (out_valid_pulse)
                    out_cnt_n = out_cnt + 1'b1;
                if (out_cnt_n == cfg_out_total)
                    state_n = S_DONE;
            end

            S_DONE: begin
                done    = 1'b1;
                state_n = S_IDLE;
            end

            default: state_n = S_IDLE;
        endcase
    end

endmodule
