EslamWaleed79/-FPGA-Based-Edge-AI-Vision-_Accelerator/Vivado_____Files/Run1/project_3.runs/design_1_processing_system7_0_0_synth_1/.Xil/design_1_processing_system7_0_0_propImpl.xdc

set_property SRC_FILE_INFO {cfile:c:/Users/compumarts/Desktop/project_3/project_3.srcs/sources_1/bd/design_1/ip/design_1_processing_system7_0_0/design_1_processing_system7_0_0.xdc rfile:../../../project_3.srcs/sources_1/bd/design_1/ip/design_1_processing_system7_0_0/design_1_processing_system7_0_0.xdc id:1 order:EARLY scoped_inst:inst} [current_design]
set_property src_info {type:SCOPED_XDC file:1 line:21 export:INPUT save:INPUT read:READ} [current_design]
set_input_jitter clk_fpga_0 0.6
set_property src_info {type:SCOPED_XDC file:1 line:30 export:INPUT save:INPUT read:READ} [current_design]
set_property PACKAGE_PIN "H5" [get_ports "DDR_VRP"]
set_property src_info {type:SCOPED_XDC file:1 line:34 export:INPUT save:INPUT read:READ} [current_design]
set_property PACKAGE_PIN "G5" [get_ports "DDR_VRN"]
set_property src_info {type:SCOPED_XDC file:1 line:38 export:INPUT save:INPUT read:READ} [current_design]
set_property PACKAGE_PIN "M5" [get_ports "DDR_WEB"]
set_property src_info {type:SCOPED_XDC file:1 line:42 export:INPUT save:INPUT read:READ} [current_design]
set_property PACKAGE_PIN "P4" [get_ports "DDR_RAS_n"]
set_property src_info {type:SCOPED_XDC file:1 line:46 export:INPUT save:INPUT read:READ} [current_design]
set_property PACKAGE_PIN "N5" [get_ports "DDR_ODT"]
set_property src_info {type:SCOPED_XDC file:1 line:50 export:INPUT save:INPUT read:READ} [current_design]
set_property PACKAGE_PIN "B4" [get_ports "DDR_DRSTB"]
set_property src_info {type:SCOPED_XDC file:1 line:54 export:INPUT save:INPUT read:READ} [current_design]
set_property PACKAGE_PIN "W5" [get_ports "DDR_DQS[3]"]
set_property src_info {type:SCOPED_XDC file:1 line:58 export:INPUT save:INPUT read:READ} [current_design]
set_property PACKAGE_PIN "R2" [get_ports "DDR_DQS[2]"]
set_property src_info {type:SCOPED_XDC file:1 line:62 export:INPUT save:INPUT read:READ} [current_design]
set_property PACKAGE_PIN "G2" [get_ports "DDR_DQS[1]"]
set_property src_info {type:SCOPED_XDC file:1 line:66 export:INPUT save:INPUT read:READ} [current_design]
set_property PACKAGE_PIN "C2" [get_ports "DDR_DQS[0]"]
set_property src_info {type:SCOPED_XDC file:1 line:70 export:INPUT save:INPUT read:READ} [current_design]
set_property PACKAGE_PIN "W4" [get_ports "DDR_DQS_n[3]"]
set_property src_info {type:SCOPED_XDC file:1 line:74 export:INPUT save:INPUT read:READ} [current_design]
set_property PACKAGE_PIN "T2" [get_ports "DDR_DQS_n[2]"]
set_property src_info {type:SCOPED_XDC file:1 line:78 export:INPUT save:INPUT read:READ} [current_design]
set_property PACKAGE_PIN "F2" [get_ports "DDR_DQS_n[1]"]
set_property src_info {type:SCOPED_XDC file:1 line:82 export:INPUT save:INPUT read:READ} [current_design]
set_property PACKAGE_PIN "B2" [get_ports "DDR_DQS_n[0]"]
set_property src_info {type:SCOPED_XDC file:1 line:86 export:INPUT save:INPUT read:READ} [current_design]
set_property PACKAGE_PIN "E3" [get_ports "DDR_DQ[9]"]
set_property src_info {type:SCOPED_XDC file:1 line:90 export:INPUT save:INPUT read:READ} [current_design]
set_property PACKAGE_PIN "E2" [get_ports "DDR_DQ[8]"]
set_property src_info {type:SCOPED_XDC file:1 line:94 export:INPUT save:INPUT read:READ} [current_design]
set_property PACKAGE_PIN "E1" [get_ports "DDR_DQ[7]"]
set_property src_info {type:SCOPED_XDC file:1 line:98 export:INPUT save:INPUT read:READ} [current_design]
set_property PACKAGE_PIN "C1" [get_ports "DDR_DQ[6]"]
set_property src_info {type:SCOPED_XDC file:1 line:102 export:INPUT save:INPUT read:READ} [current_design]
set_property PACKAGE_PIN "D1" [get_ports "DDR_DQ[5]"]
set_property src_info {type:SCOPED_XDC file:1 line:106 export:INPUT save:INPUT read:READ} [current_design]
set_property PACKAGE_PIN "D3" [get_ports "DDR_DQ[4]"]
set_property src_info {type:SCOPED_XDC file:1 line:110 export:INPUT save:INPUT read:READ} [current_design]
set_property PACKAGE_PIN "A4" [get_ports "DDR_DQ[3]"]
set_property src_info {type:SCOPED_XDC file:1 line:114 export:INPUT save:INPUT read:READ} [current_design]
set_property PACKAGE_PIN "V3" [get_ports "DDR_DQ[31]"]
set_property src_info {type:SCOPED_XDC file:1 line:118 export:INPUT save:INPUT read:READ} [current_design]
set_property PACKAGE_PIN "V2" [get_ports "DDR_DQ[30]"]
set_property src_info {type:SCOPED_XDC file:1 line:122 export:INPUT save:INPUT read:READ} [current_design]
set_property PACKAGE_PIN "A2" [get_ports "DDR_DQ[2]"]
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
set_property PACKAGE_PIN "A1" [get_ports "DDR_DM[0]"]
set_property src_info {type:SCOPED_XDC file:1 line:230 export:INPUT save:INPUT read:READ} [current_design]
set_property PACKAGE_PIN "N1" [get_ports "DDR_CS_n"]
set_property src_info {type:SCOPED_XDC file:1 line:234 export:INPUT save:INPUT read:READ} [current_design]
set_property PACKAGE_PIN "N3" [get_ports "DDR_CKE"]
set_property src_info {type:SCOPED_XDC file:1 line:238 export:INPUT save:INPUT read:READ} [current_design]
set_property PACKAGE_PIN "L2" [get_ports "DDR_Clk"]
set_property src_info {type:SCOPED_XDC file:1 line:242 export:INPUT save:INPUT read:READ} [current_design]
set_property PACKAGE_PIN "M2" [get_ports "DDR_Clk_n"]
set_property src_info {type:SCOPED_XDC file:1 line:246 export:INPUT save:INPUT read:READ} [current_design]
set_property PACKAGE_PIN "P5" [get_ports "DDR_CAS_n"]
set_property src_info {type:SCOPED_XDC file:1 line:250 export:INPUT save:INPUT read:READ} [current_design]
set_property PACKAGE_PIN "J5" [get_ports "DDR_BankAddr[2]"]
set_property src_info {type:SCOPED_XDC file:1 line:254 export:INPUT save:INPUT read:READ} [current_design]
set_property PACKAGE_PIN "R4" [get_ports "DDR_BankAddr[1]"]
set_property src_info {type:SCOPED_XDC file:1 line:258 export:INPUT save:INPUT read:READ} [current_design]
set_property PACKAGE_PIN "L5" [get_ports "DDR_BankAddr[0]"]
set_property src_info {type:SCOPED_XDC file:1 line:262 export:INPUT save:INPUT read:READ} [current_design]
set_property PACKAGE_PIN "J4" [get_ports "DDR_Addr[9]"]
set_property src_info {type:SCOPED_XDC file:1 line:266 export:INPUT save:INPUT read:READ} [current_design]
set_property PACKAGE_PIN "K1" [get_ports "DDR_Addr[8]"]
set_property src_info {type:SCOPED_XDC file:1 line:270 export:INPUT save:INPUT read:READ} [current_design]
set_property PACKAGE_PIN "K4" [get_ports "DDR_Addr[7]"]
set_property src_info {type:SCOPED_XDC file:1 line:274 export:INPUT save:INPUT read:READ} [current_design]
set_property PACKAGE_PIN "L4" [get_ports "DDR_Addr[6]"]
set_property src_info {type:SCOPED_XDC file:1 line:278 export:INPUT save:INPUT read:READ} [current_design]
set_property PACKAGE_PIN "L1" [get_ports "DDR_Addr[5]"]
set_property src_info {type:SCOPED_XDC file:1 line:282 export:INPUT save:INPUT read:READ} [current_design]
set_property PACKAGE_PIN "M4" [get_ports "DDR_Addr[4]"]
set_property src_info {type:SCOPED_XDC file:1 line:286 export:INPUT save:INPUT read:READ} [current_design]
set_property PACKAGE_PIN "K3" [get_ports "DDR_Addr[3]"]
set_property src_info {type:SCOPED_XDC file:1 line:290 export:INPUT save:INPUT read:READ} [current_design]
set_property PACKAGE_PIN "M3" [get_ports "DDR_Addr[2]"]
set_property src_info {type:SCOPED_XDC file:1 line:294 export:INPUT save:INPUT read:READ} [current_design]
set_property PACKAGE_PIN "K2" [get_ports "DDR_Addr[1]"]
set_property src_info {type:SCOPED_XDC file:1 line:298 export:INPUT save:INPUT read:READ} [current_design]
set_property PACKAGE_PIN "F4" [get_ports "DDR_Addr[14]"]
set_property src_info {type:SCOPED_XDC file:1 line:302 export:INPUT save:INPUT read:READ} [current_design]
set_property PACKAGE_PIN "D4" [get_ports "DDR_Addr[13]"]
set_property src_info {type:SCOPED_XDC file:1 line:306 export:INPUT save:INPUT read:READ} [current_design]
set_property PACKAGE_PIN "E4" [get_ports "DDR_Addr[12]"]
set_property src_info {type:SCOPED_XDC file:1 line:310 export:INPUT save:INPUT read:READ} [current_design]
set_property PACKAGE_PIN "G4" [get_ports "DDR_Addr[11]"]
set_property src_info {type:SCOPED_XDC file:1 line:314 export:INPUT save:INPUT read:READ} [current_design]
set_property PACKAGE_PIN "F5" [get_ports "DDR_Addr[10]"]
set_property src_info {type:SCOPED_XDC file:1 line:318 export:INPUT save:INPUT read:READ} [current_design]
set_property PACKAGE_PIN "N2" [get_ports "DDR_Addr[0]"]
set_property src_info {type:SCOPED_XDC file:1 line:322 export:INPUT save:INPUT read:READ} [current_design]
set_property PACKAGE_PIN "C7" [get_ports "PS_PORB"]
set_property src_info {type:SCOPED_XDC file:1 line:325 export:INPUT save:INPUT read:READ} [current_design]
set_property PACKAGE_PIN "B10" [get_ports "PS_SRSTB"]
set_property src_info {type:SCOPED_XDC file:1 line:328 export:INPUT save:INPUT read:READ} [current_design]
set_property PACKAGE_PIN "E7" [get_ports "PS_CLK"]
