EslamWaleed79/-FPGA-Based-Edge-AI-Vision-_Accelerator/Vivado_____Files/Run1/project_3.srcs/sources_1/bd/design_1/ip/design_1_axi_smc_0/synth/design_1_axi_smc_0.v

// (c) Copyright 1995-2026 Xilinx, Inc. All rights reserved.
// 
// This file contains confidential and proprietary information
// of Xilinx, Inc. and is protected under U.S. and
// international copyright and other intellectual property
// laws.
// 
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
// CRITICAL APPLICATIONS
// Xilinx products are not designed or intended to be fail-
// safe, or for use in any application requiring fail-safe
// performance, such as life-support or safety devices or
// systems, Class III medical devices, nuclear facilities,
// applications related to the deployment of airbags, or any
// other applications that could lead to death, personal
// injury, or severe property or environmental damage
// (individually and collectively, "Critical
// Applications"). Customer assumes the sole risk and
// liability of any use of Xilinx products in Critical
// Applications, subject only to applicable laws and
// regulations governing limitations on product liability.
// 
// THIS COPYRIGHT NOTICE AND DISCLAIMER MUST BE RETAINED AS
// PART OF THIS FILE AT ALL TIMES.
// 
// DO NOT MODIFY THIS FILE.


// IP VLNV: xilinx.com:ip:smartconnect:1.0
// IP Revision: 9

(* X_CORE_INFO = "bd_afc3,Vivado 2018.2" *)
(* CHECK_LICENSE_TYPE = "design_1_axi_smc_0,bd_afc3,{}" *)
(* CORE_GENERATION_INFO = "design_1_axi_smc_0,bd_afc3,{x_ipProduct=Vivado 2018.2,x_ipVendor=xilinx.com,x_ipLibrary=ip,x_ipName=smartconnect,x_ipVersion=1.0,x_ipCoreRevision=9,x_ipLanguage=VERILOG,x_ipSimLanguage=MIXED,NUM_MI=1,NUM_SI=2,NUM_CLKS=1,HAS_ARESETN=1,ADVANCED_PROPERTIES=0,Component_Name=design_1_axi_smc_0}" *)
(* DowngradeIPIdentifiedWarnings = "yes" *)
module design_1_axi_smc_0 (
  aclk,
  aresetn,
  S00_AXI_araddr,
  S00_AXI_arlen,
  S00_AXI_arsize,
  S00_AXI_arburst,
  S00_AXI_arlock,
  S00_AXI_arcache,
  S00_AXI_arprot,
  S00_AXI_arqos,
  S00_AXI_arvalid,
  S00_AXI_arready,
  S00_AXI_rdata,
  S00_AXI_rresp,
  S00_AXI_rlast,
  S00_AXI_rvalid,
  S00_AXI_rready,
  S01_AXI_awaddr,
  S01_AXI_awlen,
  S01_AXI_awsize,
  S01_AXI_awburst,
  S01_AXI_awlock,
  S01_AXI_awcache,
  S01_AXI_awprot,
  S01_AXI_awqos,
  S01_AXI_awvalid,
  S01_AXI_awready,
  S01_AXI_wdata,
  S01_AXI_wstrb,
  S01_AXI_wlast,
  S01_AXI_wvalid,
  S01_AXI_wready,
  S01_AXI_bresp,
  S01_AXI_bvalid,
  S01_AXI_bready,
  M00_AXI_awaddr,
  M00_AXI_awlen,
  M00_AXI_awsize,
  M00_AXI_awburst,
  M00_AXI_awlock,
  M00_AXI_awcache,
  M00_AXI_awprot,
  M00_AXI_awqos,
  M00_AXI_awvalid,
  M00_AXI_awready,
  M00_AXI_wdata,
  M00_AXI_wstrb,
  M00_AXI_wlast,
  M00_AXI_wvalid,
  M00_AXI_wready,
  M00_AXI_bresp,
  M00_AXI_bvalid,
  M00_AXI_bready,
  M00_AXI_araddr,
  M00_AXI_arlen,
  M00_AXI_arsize,
  M00_AXI_arburst,
  M00_AXI_arlock,
  M00_AXI_arcache,
  M00_AXI_arprot,
  M00_AXI_arqos,
  M00_AXI_arvalid,
  M00_AXI_arready,
  M00_AXI_rdata,
  M00_AXI_rresp,
  M00_AXI_rlast,
  M00_AXI_rvalid,
  M00_AXI_rready
);

(* X_INTERFACE_PARAMETER = "XIL_INTERFACENAME CLK.aclk, FREQ_HZ 50000000, PHASE 0.000, CLK_DOMAIN design_1_processing_system7_0_0_FCLK_CLK0, ASSOCIATED_BUSIF M00_AXI:S00_AXI:S01_AXI, ASSOCIATED_CLKEN m_sc_aclken" *)
(* X_INTERFACE_INFO = "xilinx.com:signal:clock:1.0 CLK.aclk CLK" *)
input wire aclk;
(* X_INTERFACE_PARAMETER = "XIL_INTERFACENAME RST.aresetn, POLARITY ACTIVE_LOW" *)
(* X_INTERFACE_INFO = "xilinx.com:signal:reset:1.0 RST.aresetn RST" *)
input wire aresetn;
(* X_INTERFACE_INFO = "xilinx.com:interface:aximm:1.0 S00_AXI ARADDR" *)
input wire [31 : 0] S00_AXI_araddr;
(* X_INTERFACE_INFO = "xilinx.com:interface:aximm:1.0 S00_AXI ARLEN" *)
input wire [7 : 0] S00_AXI_arlen;
(* X_INTERFACE_INFO = "xilinx.com:interface:aximm:1.0 S00_AXI ARSIZE" *)
input wire [2 : 0] S00_AXI_arsize;
(* X_INTERFACE_INFO = "xilinx.com:interface:aximm:1.0 S00_AXI ARBURST" *)
input wire [1 : 0] S00_AXI_arburst;
(* X_INTERFACE_INFO = "xilinx.com:interface:aximm:1.0 S00_AXI ARLOCK" *)
input wire [0 : 0] S00_AXI_arlock;
(* X_INTERFACE_INFO = "xilinx.com:interface:aximm:1.0 S00_AXI ARCACHE" *)
input wire [3 : 0] S00_AXI_arcache;
(* X_INTERFACE_INFO = "xilinx.com:interface:aximm:1.0 S00_AXI ARPROT" *)
input wire [2 : 0] S00_AXI_arprot;
(* X_INTERFACE_INFO = "xilinx.com:interface:aximm:1.0 S00_AXI ARQOS" *)
input wire [3 : 0] S00_AXI_arqos;
(* X_INTERFACE_INFO = "xilinx.com:interface:aximm:1.0 S00_AXI ARVALID" *)
input wire S00_AXI_arvalid;
(* X_INTERFACE_INFO = "xilinx.com:interface:aximm:1.0 S00_AXI ARREADY" *)
output wire S00_AXI_arready;
(* X_INTERFACE_INFO = "xilinx.com:interface:aximm:1.0 S00_AXI RDATA" *)
output wire [31 : 0] S00_AXI_rdata;
(* X_INTERFACE_INFO = "xilinx.com:interface:aximm:1.0 S00_AXI RRESP" *)
output wire [1 : 0] S00_AXI_rresp;
(* X_INTERFACE_INFO = "xilinx.com:interface:aximm:1.0 S00_AXI RLAST" *)
output wire S00_AXI_rlast;
(* X_INTERFACE_INFO = "xilinx.com:interface:aximm:1.0 S00_AXI RVALID" *)
output wire S00_AXI_rvalid;
(* X_INTERFACE_PARAMETER = "XIL_INTERFACENAME S00_AXI, DATA_WIDTH 32, PROTOCOL AXI4, FREQ_HZ 50000000, ID_WIDTH 0, ADDR_WIDTH 32, AWUSER_WIDTH 0, ARUSER_WIDTH 0, WUSER_WIDTH 0, RUSER_WIDTH 0, BUSER_WIDTH 0, READ_WRITE_MODE READ_ONLY, HAS_BURST 0, HAS_LOCK 0, HAS_PROT 0, HAS_CACHE 0, HAS_QOS 0, HAS_REGION 0, HAS_WSTRB 0, HAS_BRESP 0, HAS_RRESP 1, SUPPORTS_NARROW_BURST 0, NUM_READ_OUTSTANDING 16, NUM_WRITE_OUTSTANDING 2, MAX_BURST_LENGTH 16, PHASE 0.000, CLK_DOMAIN design_1_processing_system7_0_0_FCLK_CLK0, NUM_READ_THREADS \
1, NUM_WRITE_THREADS 1, RUSER_BITS_PER_BYTE 0, WUSER_BITS_PER_BYTE 0" *)
(* X_INTERFACE_INFO = "xilinx.com:interface:aximm:1.0 S00_AXI RREADY" *)
input wire S00_AXI_rready;
(* X_INTERFACE_INFO = "xilinx.com:interface:aximm:1.0 S01_AXI AWADDR" *)
input wire [31 : 0] S01_AXI_awaddr;
(* X_INTERFACE_INFO = "xilinx.com:interface:aximm:1.0 S01_AXI AWLEN" *)
input wire [7 : 0] S01_AXI_awlen;
(* X_INTERFACE_INFO = "xilinx.com:interface:aximm:1.0 S01_AXI AWSIZE" *)
input wire [2 : 0] S01_AXI_awsize;
(* X_INTERFACE_INFO = "xilinx.com:interface:aximm:1.0 S01_AXI AWBURST" *)
input wire [1 : 0] S01_AXI_awburst;
(* X_INTERFACE_INFO = "xilinx.com:interface:aximm:1.0 S01_AXI AWLOCK" *)
input wire [0 : 0] S01_AXI_awlock;
(* X_INTERFACE_INFO = "xilinx.com:interface:aximm:1.0 S01_AXI AWCACHE" *)
input wire [3 : 0] S01_AXI_awcache;
(* X_INTERFACE_INFO = "xilinx.com:interface:aximm:1.0 S01_AXI AWPROT" *)
input wire [2 : 0] S01_AXI_awprot;
(* X_INTERFACE_INFO = "xilinx.com:interface:aximm:1.0 S01_AXI AWQOS" *)
input wire [3 : 0] S01_AXI_awqos;
(* X_INTERFACE_INFO = "xilinx.com:interface:aximm:1.0 S01_AXI AWVALID" *)
input wire S01_AXI_awvalid;
(* X_INTERFACE_INFO = "xilinx.com:interface:aximm:1.0 S01_AXI AWREADY" *)
output wire S01_AXI_awready;
(* X_INTERFACE_INFO = "xilinx.com:interface:aximm:1.0 S01_AXI WDATA" *)
input wire [31 : 0] S01_AXI_wdata;
(* X_INTERFACE_INFO = "xilinx.com:interface:aximm:1.0 S01_AXI WSTRB" *)
input wire [3 : 0] S01_AXI_wstrb;
(* X_INTERFACE_INFO = "xilinx.com:interface:aximm:1.0 S01_AXI WLAST" *)
input wire S01_AXI_wlast;
(* X_INTERFACE_INFO = "xilinx.com:interface:aximm:1.0 S01_AXI WVALID" *)
input wire S01_AXI_wvalid;
(* X_INTERFACE_INFO = "xilinx.com:interface:aximm:1.0 S01_AXI WREADY" *)
output wire S01_AXI_wready;
(* X_INTERFACE_INFO = "xilinx.com:interface:aximm:1.0 S01_AXI BRESP" *)
output wire [1 : 0] S01_AXI_bresp;
(* X_INTERFACE_INFO = "xilinx.com:interface:aximm:1.0 S01_AXI BVALID" *)
output wire S01_AXI_bvalid;
(* X_INTERFACE_PARAMETER = "XIL_INTERFACENAME S01_AXI, DATA_WIDTH 32, PROTOCOL AXI4, FREQ_HZ 50000000, ID_WIDTH 0, ADDR_WIDTH 32, AWUSER_WIDTH 0, ARUSER_WIDTH 0, WUSER_WIDTH 0, RUSER_WIDTH 0, BUSER_WIDTH 0, READ_WRITE_MODE WRITE_ONLY, HAS_BURST 0, HAS_LOCK 0, HAS_PROT 0, HAS_CACHE 0, HAS_QOS 0, HAS_REGION 0, HAS_WSTRB 1, HAS_BRESP 1, HAS_RRESP 0, SUPPORTS_NARROW_BURST 0, NUM_READ_OUTSTANDING 2, NUM_WRITE_OUTSTANDING 16, MAX_BURST_LENGTH 16, PHASE 0.000, CLK_DOMAIN design_1_processing_system7_0_0_FCLK_CLK0, NUM_READ_THREADS\
 1, NUM_WRITE_THREADS 1, RUSER_BITS_PER_BYTE 0, WUSER_BITS_PER_BYTE 0" *)
(* X_INTERFACE_INFO = "xilinx.com:interface:aximm:1.0 S01_AXI BREADY" *)
input wire S01_AXI_bready;
(* X_INTERFACE_INFO = "xilinx.com:interface:aximm:1.0 M00_AXI AWADDR" *)
output wire [31 : 0] M00_AXI_awaddr;
(* X_INTERFACE_INFO = "xilinx.com:interface:aximm:1.0 M00_AXI AWLEN" *)
output wire [3 : 0] M00_AXI_awlen;
(* X_INTERFACE_INFO = "xilinx.com:interface:aximm:1.0 M00_AXI AWSIZE" *)
output wire [2 : 0] M00_AXI_awsize;
(* X_INTERFACE_INFO = "xilinx.com:interface:aximm:1.0 M00_AXI AWBURST" *)
output wire [1 : 0] M00_AXI_awburst;
(* X_INTERFACE_INFO = "xilinx.com:interface:aximm:1.0 M00_AXI AWLOCK" *)
output wire [1 : 0] M00_AXI_awlock;
(* X_INTERFACE_INFO = "xilinx.com:interface:aximm:1.0 M00_AXI AWCACHE" *)
output wire [3 : 0] M00_AXI_awcache;
(* X_INTERFACE_INFO = "xilinx.com:interface:aximm:1.0 M00_AXI AWPROT" *)
output wire [2 : 0] M00_AXI_awprot;
(* X_INTERFACE_INFO = "xilinx.com:interface:aximm:1.0 M00_AXI AWQOS" *)
output wire [3 : 0] M00_AXI_awqos;
(* X_INTERFACE_INFO = "xilinx.com:interface:aximm:1.0 M00_AXI AWVALID" *)
output wire M00_AXI_awvalid;
(* X_INTERFACE_INFO = "xilinx.com:interface:aximm:1.0 M00_AXI AWREADY" *)
input wire M00_AXI_awready;
(* X_INTERFACE_INFO = "xilinx.com:interface:aximm:1.0 M00_AXI WDATA" *)
output wire [63 : 0] M00_AXI_wdata;
(* X_INTERFACE_INFO = "xilinx.com:interface:aximm:1.0 M00_AXI WSTRB" *)
output wire [7 : 0] M00_AXI_wstrb;
(* X_INTERFACE_INFO = "xilinx.com:interface:aximm:1.0 M00_AXI WLAST" *)
output wire M00_AXI_wlast;
(* X_INTERFACE_INFO = "xilinx.com:interface:aximm:1.0 M00_AXI WVALID" *)
output wire M00_AXI_wvalid;
(* X_INTERFACE_INFO = "xilinx.com:interface:aximm:1.0 M00_AXI WREADY" *)
input wire M00_AXI_wready;
(* X_INTERFACE_INFO = "xilinx.com:interface:aximm:1.0 M00_AXI BRESP" *)
input wire [1 : 0] M00_AXI_bresp;
(* X_INTERFACE_INFO = "xilinx.com:interface:aximm:1.0 M00_AXI BVALID" *)
input wire M00_AXI_bvalid;
(* X_INTERFACE_INFO = "xilinx.com:interface:aximm:1.0 M00_AXI BREADY" *)
output wire M00_AXI_bready;
(* X_INTERFACE_INFO = "xilinx.com:interface:aximm:1.0 M00_AXI ARADDR" *)
output wire [31 : 0] M00_AXI_araddr;
(* X_INTERFACE_INFO = "xilinx.com:interface:aximm:1.0 M00_AXI ARLEN" *)
output wire [3 : 0] M00_AXI_arlen;
(* X_INTERFACE_INFO = "xilinx.com:interface:aximm:1.0 M00_AXI ARSIZE" *)
output wire [2 : 0] M00_AXI_arsize;
(* X_INTERFACE_INFO = "xilinx.com:interface:aximm:1.0 M00_AXI ARBURST" *)
output wire [1 : 0] M00_AXI_arburst;
(* X_INTERFACE_INFO = "xilinx.com:interface:aximm:1.0 M00_AXI ARLOCK" *)
output wire [1 : 0] M00_AXI_arlock;
(* X_INTERFACE_INFO = "xilinx.com:interface:aximm:1.0 M00_AXI ARCACHE" *)
output wire [3 : 0] M00_AXI_arcache;
(* X_INTERFACE_INFO = "xilinx.com:interface:aximm:1.0 M00_AXI ARPROT" *)
output wire [2 : 0] M00_AXI_arprot;
(* X_INTERFACE_INFO = "xilinx.com:interface:aximm:1.0 M00_AXI ARQOS" *)
output wire [3 : 0] M00_AXI_arqos;
(* X_INTERFACE_INFO = "xilinx.com:interface:aximm:1.0 M00_AXI ARVALID" *)
output wire M00_AXI_arvalid;
(* X_INTERFACE_INFO = "xilinx.com:interface:aximm:1.0 M00_AXI ARREADY" *)
input wire M00_AXI_arready;
(* X_INTERFACE_INFO = "xilinx.com:interface:aximm:1.0 M00_AXI RDATA" *)
input wire [63 : 0] M00_AXI_rdata;
(* X_INTERFACE_INFO = "xilinx.com:interface:aximm:1.0 M00_AXI RRESP" *)
input wire [1 : 0] M00_AXI_rresp;
(* X_INTERFACE_INFO = "xilinx.com:interface:aximm:1.0 M00_AXI RLAST" *)
input wire M00_AXI_rlast;
(* X_INTERFACE_INFO = "xilinx.com:interface:aximm:1.0 M00_AXI RVALID" *)
input wire M00_AXI_rvalid;
(* X_INTERFACE_PARAMETER = "XIL_INTERFACENAME M00_AXI, DATA_WIDTH 64, PROTOCOL AXI3, FREQ_HZ 50000000, ID_WIDTH 0, ADDR_WIDTH 32, AWUSER_WIDTH 0, ARUSER_WIDTH 0, WUSER_WIDTH 0, RUSER_WIDTH 0, BUSER_WIDTH 0, READ_WRITE_MODE READ_WRITE, HAS_BURST 1, HAS_LOCK 1, HAS_PROT 1, HAS_CACHE 1, HAS_QOS 1, HAS_REGION 0, HAS_WSTRB 1, HAS_BRESP 1, HAS_RRESP 1, SUPPORTS_NARROW_BURST 0, NUM_READ_OUTSTANDING 2, NUM_WRITE_OUTSTANDING 2, MAX_BURST_LENGTH 8, PHASE 0.000, CLK_DOMAIN design_1_processing_system7_0_0_FCLK_CLK0, NUM_READ_THREADS 1\
, NUM_WRITE_THREADS 1, RUSER_BITS_PER_BYTE 0, WUSER_BITS_PER_BYTE 0" *)
(* X_INTERFACE_INFO = "xilinx.com:interface:aximm:1.0 M00_AXI RREADY" *)
output wire M00_AXI_rready;

  bd_afc3 inst (
    .aclk(aclk),
    .aresetn(aresetn),
    .S00_AXI_araddr(S00_AXI_araddr),
    .S00_AXI_arlen(S00_AXI_arlen),
    .S00_AXI_arsize(S00_AXI_arsize),
    .S00_AXI_arburst(S00_AXI_arburst),
    .S00_AXI_arlock(S00_AXI_arlock),
    .S00_AXI_arcache(S00_AXI_arcache),
    .S00_AXI_arprot(S00_AXI_arprot),
    .S00_AXI_arqos(S00_AXI_arqos),
    .S00_AXI_arvalid(S00_AXI_arvalid),
    .S00_AXI_arready(S00_AXI_arready),
    .S00_AXI_rdata(S00_AXI_rdata),
    .S00_AXI_rresp(S00_AXI_rresp),
    .S00_AXI_rlast(S00_AXI_rlast),
    .S00_AXI_rvalid(S00_AXI_rvalid),
    .S00_AXI_rready(S00_AXI_rready),
    .S01_AXI_awaddr(S01_AXI_awaddr),
    .S01_AXI_awlen(S01_AXI_awlen),
    .S01_AXI_awsize(S01_AXI_awsize),
    .S01_AXI_awburst(S01_AXI_awburst),
    .S01_AXI_awlock(S01_AXI_awlock),
    .S01_AXI_awcache(S01_AXI_awcache),
    .S01_AXI_awprot(S01_AXI_awprot),
    .S01_AXI_awqos(S01_AXI_awqos),
    .S01_AXI_awvalid(S01_AXI_awvalid),
    .S01_AXI_awready(S01_AXI_awready),
    .S01_AXI_wdata(S01_AXI_wdata),
    .S01_AXI_wstrb(S01_AXI_wstrb),
    .S01_AXI_wlast(S01_AXI_wlast),
    .S01_AXI_wvalid(S01_AXI_wvalid),
    .S01_AXI_wready(S01_AXI_wready),
    .S01_AXI_bresp(S01_AXI_bresp),
    .S01_AXI_bvalid(S01_AXI_bvalid),
    .S01_AXI_bready(S01_AXI_bready),
    .M00_AXI_awaddr(M00_AXI_awaddr),
    .M00_AXI_awlen(M00_AXI_awlen),
    .M00_AXI_awsize(M00_AXI_awsize),
    .M00_AXI_awburst(M00_AXI_awburst),
    .M00_AXI_awlock(M00_AXI_awlock),
    .M00_AXI_awcache(M00_AXI_awcache),
    .M00_AXI_awprot(M00_AXI_awprot),
    .M00_AXI_awqos(M00_AXI_awqos),
    .M00_AXI_awvalid(M00_AXI_awvalid),
    .M00_AXI_awready(M00_AXI_awready),
    .M00_AXI_wdata(M00_AXI_wdata),
    .M00_AXI_wstrb(M00_AXI_wstrb),
    .M00_AXI_wlast(M00_AXI_wlast),
    .M00_AXI_wvalid(M00_AXI_wvalid),
    .M00_AXI_wready(M00_AXI_wready),
    .M00_AXI_bresp(M00_AXI_bresp),
    .M00_AXI_bvalid(M00_AXI_bvalid),
    .M00_AXI_bready(M00_AXI_bready),
    .M00_AXI_araddr(M00_AXI_araddr),
    .M00_AXI_arlen(M00_AXI_arlen),
    .M00_AXI_arsize(M00_AXI_arsize),
    .M00_AXI_arburst(M00_AXI_arburst),
    .M00_AXI_arlock(M00_AXI_arlock),
    .M00_AXI_arcache(M00_AXI_arcache),
    .M00_AXI_arprot(M00_AXI_arprot),
    .M00_AXI_arqos(M00_AXI_arqos),
    .M00_AXI_arvalid(M00_AXI_arvalid),
    .M00_AXI_arready(M00_AXI_arready),
    .M00_AXI_rdata(M00_AXI_rdata),
    .M00_AXI_rresp(M00_AXI_rresp),
    .M00_AXI_rlast(M00_AXI_rlast),
    .M00_AXI_rvalid(M00_AXI_rvalid),
    .M00_AXI_rready(M00_AXI_rready)
  );
endmodule
