EslamWaleed79/-FPGA-Based-Edge-AI-Vision-_Accelerator/Vivado_____Files/Run1/project_3.cache/ip/2018.2/5e775ec5af7193b1/design_1_processing_system7_0_0_stub.vhdl

-- Copyright 1986-2018 Xilinx, Inc. All Rights Reserved.
-- --------------------------------------------------------------------------------
-- Tool Version: Vivado v.2018.2 (win64) Build 2258646 Thu Jun 14 20:03:12 MDT 2018
-- Date        : Thu Sep 10 00:08:28 2026
-- Host        : DESKTOP-1IDCUPR running 64-bit major release  (build 9200)
-- Command     : write_vhdl -force -mode synth_stub -rename_top decalper_eb_ot_sdeen_pot_pi_dehcac_xnilix -prefix
--               decalper_eb_ot_sdeen_pot_pi_dehcac_xnilix_ design_1_processing_system7_0_0_stub.vhdl
-- Design      : design_1_processing_system7_0_0
-- Purpose     : Stub declaration of top-level module interface
-- Device      : xc7z020clg400-1
-- --------------------------------------------------------------------------------
library IEEE;
use IEEE.STD_LOGIC_1164.ALL;

entity decalper_eb_ot_sdeen_pot_pi_dehcac_xnilix is
  Port ( 
    M_AXI_GP0_ARVALID : out STD_LOGIC;
    M_AXI_GP0_AWVALID : out STD_LOGIC;
    M_AXI_GP0_BREADY : out STD_LOGIC;
    M_AXI_GP0_RREADY : out STD_LOGIC;
    M_AXI_GP0_WLAST : out STD_LOGIC;
    M_AXI_GP0_WVALID : out STD_LOGIC;
    M_AXI_GP0_ARID : out STD_LOGIC_VECTOR ( 11 downto 0 );
    M_AXI_GP0_AWID : out STD_LOGIC_VECTOR ( 11 downto 0 );
    M_AXI_GP0_WID : out STD_LOGIC_VECTOR ( 11 downto 0 );
    M_AXI_GP0_ARBURST : out STD_LOGIC_VECTOR ( 1 downto 0 );
    M_AXI_GP0_ARLOCK : out STD_LOGIC_VECTOR ( 1 downto 0 );
    M_AXI_GP0_ARSIZE : out STD_LOGIC_VECTOR ( 2 downto 0 );
    M_AXI_GP0_AWBURST : out STD_LOGIC_VECTOR ( 1 downto 0 );
    M_AXI_GP0_AWLOCK : out STD_LOGIC_VECTOR ( 1 downto 0 );
    M_AXI_GP0_AWSIZE : out STD_LOGIC_VECTOR ( 2 downto 0 );
    M_AXI_GP0_ARPROT : out STD_LOGIC_VECTOR ( 2 downto 0 );
    M_AXI_GP0_AWPROT : out STD_LOGIC_VECTOR ( 2 downto 0 );
    M_AXI_GP0_ARADDR : out STD_LOGIC_VECTOR ( 31 downto 0 );
    M_AXI_GP0_AWADDR : out STD_LOGIC_VECTOR ( 31 downto 0 );
    M_AXI_GP0_WDATA : out STD_LOGIC_VECTOR ( 31 downto 0 );
    M_AXI_GP0_ARCACHE : out STD_LOGIC_VECTOR ( 3 downto 0 );
    M_AXI_GP0_ARLEN : out STD_LOGIC_VECTOR ( 3 downto 0 );
    M_AXI_GP0_ARQOS : out STD_LOGIC_VECTOR ( 3 downto 0 );
    M_AXI_GP0_AWCACHE : out STD_LOGIC_VECTOR ( 3 downto 0 );
    M_AXI_GP0_AWLEN : out STD_LOGIC_VECTOR ( 3 downto 0 );
    M_AXI_GP0_AWQOS : out STD_LOGIC_VECTOR ( 3 downto 0 );
    M_AXI_GP0_WSTRB : out STD_LOGIC_VECTOR ( 3 downto 0 );
    M_AXI_GP0_ACLK : in STD_LOGIC;
    M_AXI_GP0_ARREADY : in STD_LOGIC;
    M_AXI_GP0_AWREADY : in STD_LOGIC;
    M_AXI_GP0_BVALID : in STD_LOGIC;
    M_AXI_GP0_RLAST : in STD_LOGIC;
    M_AXI_GP0_RVALID : in STD_LOGIC;
    M_AXI_GP0_WREADY : in STD_LOGIC;
    M_AXI_GP0_BID : in STD_LOGIC_VECTOR ( 11 downto 0 );
    M_AXI_GP0_RID : in STD_LOGIC_VECTOR ( 11 downto 0 );
    M_AXI_GP0_BRESP : in STD_LOGIC_VECTOR ( 1 downto 0 );
    M_AXI_GP0_RRESP : in STD_LOGIC_VECTOR ( 1 downto 0 );
    M_AXI_GP0_RDATA : in STD_LOGIC_VECTOR ( 31 downto 0 );
    S_AXI_HP0_ARREADY : out STD_LOGIC;
    S_AXI_HP0_AWREADY : out STD_LOGIC;
    S_AXI_HP0_BVALID : out STD_LOGIC;
    S_AXI_HP0_RLAST : out STD_LOGIC;
    S_AXI_HP0_RVALID : out STD_LOGIC;
    S_AXI_HP0_WREADY : out STD_LOGIC;
    S_AXI_HP0_BRESP : out STD_LOGIC_VECTOR ( 1 downto 0 );
    S_AXI_HP0_RRESP : out STD_LOGIC_VECTOR ( 1 downto 0 );
    S_AXI_HP0_BID : out STD_LOGIC_VECTOR ( 5 downto 0 );
    S_AXI_HP0_RID : out STD_LOGIC_VECTOR ( 5 downto 0 );
    S_AXI_HP0_RDATA : out STD_LOGIC_VECTOR ( 63 downto 0 );
    S_AXI_HP0_RCOUNT : out STD_LOGIC_VECTOR ( 7 downto 0 );
    S_AXI_HP0_WCOUNT : out STD_LOGIC_VECTOR ( 7 downto 0 );
    S_AXI_HP0_RACOUNT : out STD_LOGIC_VECTOR ( 2 downto 0 );
    S_AXI_HP0_WACOUNT : out STD_LOGIC_VECTOR ( 5 downto 0 );
    S_AXI_HP0_ACLK : in STD_LOGIC;
    S_AXI_HP0_ARVALID : in STD_LOGIC;
    S_AXI_HP0_AWVALID : in STD_LOGIC;
    S_AXI_HP0_BREADY : in STD_LOGIC;
    S_AXI_HP0_RDISSUECAP1_EN : in STD_LOGIC;
    S_AXI_HP0_RREADY : in STD_LOGIC;
    S_AXI_HP0_WLAST : in STD_LOGIC;
    S_AXI_HP0_WRISSUECAP1_EN : in STD_LOGIC;
    S_AXI_HP0_WVALID : in STD_LOGIC;
    S_AXI_HP0_ARBURST : in STD_LOGIC_VECTOR ( 1 downto 0 );
    S_AXI_HP0_ARLOCK : in STD_LOGIC_VECTOR ( 1 downto 0 );
    S_AXI_HP0_ARSIZE : in STD_LOGIC_VECTOR ( 2 downto 0 );
    S_AXI_HP0_AWBURST : in STD_LOGIC_VECTOR ( 1 downto 0 );
    S_AXI_HP0_AWLOCK : in STD_LOGIC_VECTOR ( 1 downto 0 );
    S_AXI_HP0_AWSIZE : in STD_LOGIC_VECTOR ( 2 downto 0 );
    S_AXI_HP0_ARPROT : in STD_LOGIC_VECTOR ( 2 downto 0 );
    S_AXI_HP0_AWPROT : in STD_LOGIC_VECTOR ( 2 downto 0 );
    S_AXI_HP0_ARADDR : in STD_LOGIC_VECTOR ( 31 downto 0 );
    S_AXI_HP0_AWADDR : in STD_LOGIC_VECTOR ( 31 downto 0 );
    S_AXI_HP0_ARCACHE : in STD_LOGIC_VECTOR ( 3 downto 0 );
    S_AXI_HP0_ARLEN : in STD_LOGIC_VECTOR ( 3 downto 0 );
    S_AXI_HP0_ARQOS : in STD_LOGIC_VECTOR ( 3 downto 0 );
    S_AXI_HP0_AWCACHE : in STD_LOGIC_VECTOR ( 3 downto 0 );
    S_AXI_HP0_AWLEN : in STD_LOGIC_VECTOR ( 3 downto 0 );
    S_AXI_HP0_AWQOS : in STD_LOGIC_VECTOR ( 3 downto 0 );
    S_AXI_HP0_ARID : in STD_LOGIC_VECTOR ( 5 downto 0 );
    S_AXI_HP0_AWID : in STD_LOGIC_VECTOR ( 5 downto 0 );
    S_AXI_HP0_WID : in STD_LOGIC_VECTOR ( 5 downto 0 );
    S_AXI_HP0_WDATA : in STD_LOGIC_VECTOR ( 63 downto 0 );
    S_AXI_HP0_WSTRB : in STD_LOGIC_VECTOR ( 7 downto 0 );
    FCLK_CLK0 : out STD_LOGIC;
    FCLK_RESET0_N : out STD_LOGIC;
    MIO : inout STD_LOGIC_VECTOR ( 53 downto 0 );
    DDR_CAS_n : inout STD_LOGIC;
    DDR_CKE : inout STD_LOGIC;
    DDR_Clk_n : inout STD_LOGIC;
    DDR_Clk : inout STD_LOGIC;
    DDR_CS_n : inout STD_LOGIC;
    DDR_DRSTB : inout STD_LOGIC;
    DDR_ODT : inout STD_LOGIC;
    DDR_RAS_n : inout STD_LOGIC;
    DDR_WEB : inout STD_LOGIC;
    DDR_BankAddr : inout STD_LOGIC_VECTOR ( 2 downto 0 );
    DDR_Addr : inout STD_LOGIC_VECTOR ( 14 downto 0 );
    DDR_VRN : inout STD_LOGIC;
    DDR_VRP : inout STD_LOGIC;
    DDR_DM : inout STD_LOGIC_VECTOR ( 3 downto 0 );
    DDR_DQ : inout STD_LOGIC_VECTOR ( 31 downto 0 );
    DDR_DQS_n : inout STD_LOGIC_VECTOR ( 3 downto 0 );
    DDR_DQS : inout STD_LOGIC_VECTOR ( 3 downto 0 );
    PS_SRSTB : inout STD_LOGIC;
    PS_CLK : inout STD_LOGIC;
    PS_PORB : inout STD_LOGIC
  );

end decalper_eb_ot_sdeen_pot_pi_dehcac_xnilix;

architecture stub of decalper_eb_ot_sdeen_pot_pi_dehcac_xnilix is
attribute syn_black_box : boolean;
attribute black_box_pad_pin : string;
attribute syn_black_box of stub : architecture is true;
attribute black_box_pad_pin of stub : architecture is "M_AXI_GP0_ARVALID,M_AXI_GP0_AWVALID,M_AXI_GP0_BREADY,M_AXI_GP0_RREADY,M_AXI_GP0_WLAST,M_AXI_GP0_WVALID,M_AXI_GP0_ARID[11:0],M_AXI_GP0_AWID[11:0],M_AXI_GP0_WID[11:0],M_AXI_GP0_ARBURST[1:0],M_AXI_GP0_ARLOCK[1:0],M_AXI_GP0_ARSIZE[2:0],M_AXI_GP0_AWBURST[1:0],M_AXI_GP0_AWLOCK[1:0],M_AXI_GP0_AWSIZE[2:0],M_AXI_GP0_ARPROT[2:0],M_AXI_GP0_AWPROT[2:0],M_AXI_GP0_ARADDR[31:0],M_AXI_GP0_AWADDR[31:0],M_AXI_GP0_WDATA[31:0],M_AXI_GP0_ARCACHE[3:0],M_AXI_GP0_ARLEN[3:0],M_AXI_GP0_ARQOS[3:0],M_AXI_GP0_AWCACHE[3:0],M_AXI_GP0_AWLEN[3:0],M_AXI_GP0_AWQOS[3:0],M_AXI_GP0_WSTRB[3:0],M_AXI_GP0_ACLK,M_AXI_GP0_ARREADY,M_AXI_GP0_AWREADY,M_AXI_GP0_BVALID,M_AXI_GP0_RLAST,M_AXI_GP0_RVALID,M_AXI_GP0_WREADY,M_AXI_GP0_BID[11:0],M_AXI_GP0_RID[11:0],M_AXI_GP0_BRESP[1:0],M_AXI_GP0_RRESP[1:0],M_AXI_GP0_RDATA[31:0],S_AXI_HP0_ARREADY,S_AXI_HP0_AWREADY,S_AXI_HP0_BVALID,S_AXI_HP0_RLAST,S_AXI_HP0_RVALID,S_AXI_HP0_WREADY,S_AXI_HP0_BRESP[1:0],S_AXI_HP0_RRESP[1:0],S_AXI_HP0_BID[5:0],S_AXI_HP0_RID[5:0],S_AXI_HP0_RDATA[63:0],S_AXI_HP0_RCOUNT[7:0],S_AXI_HP0_WCOUNT[7:0],S_AXI_HP0_RACOUNT[2:0],S_AXI_HP0_WACOUNT[5:0],S_AXI_HP0_ACLK,S_AXI_HP0_ARVALID,S_AXI_HP0_AWVALID,S_AXI_HP0_BREADY,S_AXI_HP0_RDISSUECAP1_EN,S_AXI_HP0_RREADY,S_AXI_HP0_WLAST,S_AXI_HP0_WRISSUECAP1_EN,S_AXI_HP0_WVALID,S_AXI_HP0_ARBURST[1:0],S_AXI_HP0_ARLOCK[1:0],S_AXI_HP0_ARSIZE[2:0],S_AXI_HP0_AWBURST[1:0],S_AXI_HP0_AWLOCK[1:0],S_AXI_HP0_AWSIZE[2:0],S_AXI_HP0_ARPROT[2:0],S_AXI_HP0_AWPROT[2:0],S_AXI_HP0_ARADDR[31:0],S_AXI_HP0_AWADDR[31:0],S_AXI_HP0_ARCACHE[3:0],S_AXI_HP0_ARLEN[3:0],S_AXI_HP0_ARQOS[3:0],S_AXI_HP0_AWCACHE[3:0],S_AXI_HP0_AWLEN[3:0],S_AXI_HP0_AWQOS[3:0],S_AXI_HP0_ARID[5:0],S_AXI_HP0_AWID[5:0],S_AXI_HP0_WID[5:0],S_AXI_HP0_WDATA[63:0],S_AXI_HP0_WSTRB[7:0],FCLK_CLK0,FCLK_RESET0_N,MIO[53:0],DDR_CAS_n,DDR_CKE,DDR_Clk_n,DDR_Clk,DDR_CS_n,DDR_DRSTB,DDR_ODT,DDR_RAS_n,DDR_WEB,DDR_BankAddr[2:0],DDR_Addr[14:0],DDR_VRN,DDR_VRP,DDR_DM[3:0],DDR_DQ[31:0],DDR_DQS_n[3:0],DDR_DQS[3:0],PS_SRSTB,PS_CLK,PS_PORB";
attribute X_CORE_INFO : string;
attribute X_CORE_INFO of stub : architecture is "processing_system7_v5_5_processing_system7,Vivado 2018.2";
begin
end;
