EslamWaleed79/-FPGA-Based-Edge-AI-Vision-_Accelerator/Vivado_____Files/Run1/project_3.cache/ip/2018.2/6c5a014010e5a89b/design_1_auto_pc_0_stub.v

// Copyright 1986-2018 Xilinx, Inc. All Rights Reserved.
// --------------------------------------------------------------------------------
// Tool Version: Vivado v.2018.2 (win64) Build 2258646 Thu Jun 14 20:03:12 MDT 2018
// Date        : Wed Sep  9 23:46:17 2026
// Host        : DESKTOP-1IDCUPR running 64-bit major release  (build 9200)
// Command     : write_verilog -force -mode synth_stub -rename_top decalper_eb_ot_sdeen_pot_pi_dehcac_xnilix -prefix
//               decalper_eb_ot_sdeen_pot_pi_dehcac_xnilix_ design_1_auto_pc_0_stub.v
// Design      : design_1_auto_pc_0
// Purpose     : Stub declaration of top-level module interface
// Device      : xc7z020clg400-1
// --------------------------------------------------------------------------------

// This empty module with port declaration file causes synthesis tools to infer a black box for IP.
// The synthesis directives are for Synopsys Synplify support to prevent IO buffer insertion.
// Please paste the declaration into a Verilog source file or add the file as an additional source.
(* X_CORE_INFO = "axi_protocol_converter_v2_1_17_axi_protocol_converter,Vivado 2018.2" *)
module decalper_eb_ot_sdeen_pot_pi_dehcac_xnilix(aclk, aresetn, s_axi_awid, s_axi_awaddr, 
  s_axi_awlen, s_axi_awsize, s_axi_awburst, s_axi_awlock, s_axi_awcache, s_axi_awprot, 
  s_axi_awqos, s_axi_awvalid, s_axi_awready, s_axi_wid, s_axi_wdata, s_axi_wstrb, s_axi_wlast, 
  s_axi_wvalid, s_axi_wready, s_axi_bid, s_axi_bresp, s_axi_bvalid, s_axi_bready, s_axi_arid, 
  s_axi_araddr, s_axi_arlen, s_axi_arsize, s_axi_arburst, s_axi_arlock, s_axi_arcache, 
  s_axi_arprot, s_axi_arqos, s_axi_arvalid, s_axi_arready, s_axi_rid, s_axi_rdata, s_axi_rresp, 
  s_axi_rlast, s_axi_rvalid, s_axi_rready, m_axi_awaddr, m_axi_awprot, m_axi_awvalid, 
  m_axi_awready, m_axi_wdata, m_axi_wstrb, m_axi_wvalid, m_axi_wready, m_axi_bresp, 
  m_axi_bvalid, m_axi_bready, m_axi_araddr, m_axi_arprot, m_axi_arvalid, m_axi_arready, 
  m_axi_rdata, m_axi_rresp, m_axi_rvalid, m_axi_rready)
/* synthesis syn_black_box black_box_pad_pin="aclk,aresetn,s_axi_awid[11:0],s_axi_awaddr[31:0],s_axi_awlen[3:0],s_axi_awsize[2:0],s_axi_awburst[1:0],s_axi_awlock[1:0],s_axi_awcache[3:0],s_axi_awprot[2:0],s_axi_awqos[3:0],s_axi_awvalid,s_axi_awready,s_axi_wid[11:0],s_axi_wdata[31:0],s_axi_wstrb[3:0],s_axi_wlast,s_axi_wvalid,s_axi_wready,s_axi_bid[11:0],s_axi_bresp[1:0],s_axi_bvalid,s_axi_bready,s_axi_arid[11:0],s_axi_araddr[31:0],s_axi_arlen[3:0],s_axi_arsize[2:0],s_axi_arburst[1:0],s_axi_arlock[1:0],s_axi_arcache[3:0],s_axi_arprot[2:0],s_axi_arqos[3:0],s_axi_arvalid,s_axi_arready,s_axi_rid[11:0],s_axi_rdata[31:0],s_axi_rresp[1:0],s_axi_rlast,s_axi_rvalid,s_axi_rready,m_axi_awaddr[31:0],m_axi_awprot[2:0],m_axi_awvalid,m_axi_awready,m_axi_wdata[31:0],m_axi_wstrb[3:0],m_axi_wvalid,m_axi_wready,m_axi_bresp[1:0],m_axi_bvalid,m_axi_bready,m_axi_araddr[31:0],m_axi_arprot[2:0],m_axi_arvalid,m_axi_arready,m_axi_rdata[31:0],m_axi_rresp[1:0],m_axi_rvalid,m_axi_rready" */;
  input aclk;
  input aresetn;
  input [11:0]s_axi_awid;
  input [31:0]s_axi_awaddr;
  input [3:0]s_axi_awlen;
  input [2:0]s_axi_awsize;
  input [1:0]s_axi_awburst;
  input [1:0]s_axi_awlock;
  input [3:0]s_axi_awcache;
  input [2:0]s_axi_awprot;
  input [3:0]s_axi_awqos;
  input s_axi_awvalid;
  output s_axi_awready;
  input [11:0]s_axi_wid;
  input [31:0]s_axi_wdata;
  input [3:0]s_axi_wstrb;
  input s_axi_wlast;
  input s_axi_wvalid;
  output s_axi_wready;
  output [11:0]s_axi_bid;
  output [1:0]s_axi_bresp;
  output s_axi_bvalid;
  input s_axi_bready;
  input [11:0]s_axi_arid;
  input [31:0]s_axi_araddr;
  input [3:0]s_axi_arlen;
  input [2:0]s_axi_arsize;
  input [1:0]s_axi_arburst;
  input [1:0]s_axi_arlock;
  input [3:0]s_axi_arcache;
  input [2:0]s_axi_arprot;
  input [3:0]s_axi_arqos;
  input s_axi_arvalid;
  output s_axi_arready;
  output [11:0]s_axi_rid;
  output [31:0]s_axi_rdata;
  output [1:0]s_axi_rresp;
  output s_axi_rlast;
  output s_axi_rvalid;
  input s_axi_rready;
  output [31:0]m_axi_awaddr;
  output [2:0]m_axi_awprot;
  output m_axi_awvalid;
  input m_axi_awready;
  output [31:0]m_axi_wdata;
  output [3:0]m_axi_wstrb;
  output m_axi_wvalid;
  input m_axi_wready;
  input [1:0]m_axi_bresp;
  input m_axi_bvalid;
  output m_axi_bready;
  output [31:0]m_axi_araddr;
  output [2:0]m_axi_arprot;
  output m_axi_arvalid;
  input m_axi_arready;
  input [31:0]m_axi_rdata;
  input [1:0]m_axi_rresp;
  input m_axi_rvalid;
  output m_axi_rready;
endmodule
