EslamWaleed79/-FPGA-Based-Edge-AI-Vision-_Accelerator/Vivado_____Files/Run1/project_3.cache/ip/2018.2/834a266d3c0b1bb2/design_1_axi_smc_0_stub.v

// Copyright 1986-2018 Xilinx, Inc. All Rights Reserved.
// --------------------------------------------------------------------------------
// Tool Version: Vivado v.2018.2 (win64) Build 2258646 Thu Jun 14 20:03:12 MDT 2018
// Date        : Thu Sep 10 13:42:07 2026
// Host        : DESKTOP-1IDCUPR running 64-bit major release  (build 9200)
// Command     : write_verilog -force -mode synth_stub -rename_top decalper_eb_ot_sdeen_pot_pi_dehcac_xnilix -prefix
//               decalper_eb_ot_sdeen_pot_pi_dehcac_xnilix_ design_1_axi_smc_0_stub.v
// Design      : design_1_axi_smc_0
// Purpose     : Stub declaration of top-level module interface
// Device      : xc7z020clg400-1
// --------------------------------------------------------------------------------

// This empty module with port declaration file causes synthesis tools to infer a black box for IP.
// The synthesis directives are for Synopsys Synplify support to prevent IO buffer insertion.
// Please paste the declaration into a Verilog source file or add the file as an additional source.
(* X_CORE_INFO = "bd_afc3,Vivado 2018.2" *)
module decalper_eb_ot_sdeen_pot_pi_dehcac_xnilix(aclk, aresetn, S00_AXI_araddr, S00_AXI_arlen, 
  S00_AXI_arsize, S00_AXI_arburst, S00_AXI_arlock, S00_AXI_arcache, S00_AXI_arprot, 
  S00_AXI_arqos, S00_AXI_arvalid, S00_AXI_arready, S00_AXI_rdata, S00_AXI_rresp, 
  S00_AXI_rlast, S00_AXI_rvalid, S00_AXI_rready, S01_AXI_awaddr, S01_AXI_awlen, 
  S01_AXI_awsize, S01_AXI_awburst, S01_AXI_awlock, S01_AXI_awcache, S01_AXI_awprot, 
  S01_AXI_awqos, S01_AXI_awvalid, S01_AXI_awready, S01_AXI_wdata, S01_AXI_wstrb, 
  S01_AXI_wlast, S01_AXI_wvalid, S01_AXI_wready, S01_AXI_bresp, S01_AXI_bvalid, 
  S01_AXI_bready, M00_AXI_awaddr, M00_AXI_awlen, M00_AXI_awsize, M00_AXI_awburst, 
  M00_AXI_awlock, M00_AXI_awcache, M00_AXI_awprot, M00_AXI_awqos, M00_AXI_awvalid, 
  M00_AXI_awready, M00_AXI_wdata, M00_AXI_wstrb, M00_AXI_wlast, M00_AXI_wvalid, 
  M00_AXI_wready, M00_AXI_bresp, M00_AXI_bvalid, M00_AXI_bready, M00_AXI_araddr, 
  M00_AXI_arlen, M00_AXI_arsize, M00_AXI_arburst, M00_AXI_arlock, M00_AXI_arcache, 
  M00_AXI_arprot, M00_AXI_arqos, M00_AXI_arvalid, M00_AXI_arready, M00_AXI_rdata, 
  M00_AXI_rresp, M00_AXI_rlast, M00_AXI_rvalid, M00_AXI_rready)
/* synthesis syn_black_box black_box_pad_pin="aclk,aresetn,S00_AXI_araddr[31:0],S00_AXI_arlen[7:0],S00_AXI_arsize[2:0],S00_AXI_arburst[1:0],S00_AXI_arlock[0:0],S00_AXI_arcache[3:0],S00_AXI_arprot[2:0],S00_AXI_arqos[3:0],S00_AXI_arvalid,S00_AXI_arready,S00_AXI_rdata[31:0],S00_AXI_rresp[1:0],S00_AXI_rlast,S00_AXI_rvalid,S00_AXI_rready,S01_AXI_awaddr[31:0],S01_AXI_awlen[7:0],S01_AXI_awsize[2:0],S01_AXI_awburst[1:0],S01_AXI_awlock[0:0],S01_AXI_awcache[3:0],S01_AXI_awprot[2:0],S01_AXI_awqos[3:0],S01_AXI_awvalid,S01_AXI_awready,S01_AXI_wdata[31:0],S01_AXI_wstrb[3:0],S01_AXI_wlast,S01_AXI_wvalid,S01_AXI_wready,S01_AXI_bresp[1:0],S01_AXI_bvalid,S01_AXI_bready,M00_AXI_awaddr[31:0],M00_AXI_awlen[3:0],M00_AXI_awsize[2:0],M00_AXI_awburst[1:0],M00_AXI_awlock[1:0],M00_AXI_awcache[3:0],M00_AXI_awprot[2:0],M00_AXI_awqos[3:0],M00_AXI_awvalid,M00_AXI_awready,M00_AXI_wdata[63:0],M00_AXI_wstrb[7:0],M00_AXI_wlast,M00_AXI_wvalid,M00_AXI_wready,M00_AXI_bresp[1:0],M00_AXI_bvalid,M00_AXI_bready,M00_AXI_araddr[31:0],M00_AXI_arlen[3:0],M00_AXI_arsize[2:0],M00_AXI_arburst[1:0],M00_AXI_arlock[1:0],M00_AXI_arcache[3:0],M00_AXI_arprot[2:0],M00_AXI_arqos[3:0],M00_AXI_arvalid,M00_AXI_arready,M00_AXI_rdata[63:0],M00_AXI_rresp[1:0],M00_AXI_rlast,M00_AXI_rvalid,M00_AXI_rready" */;
  input aclk;
  input aresetn;
  input [31:0]S00_AXI_araddr;
  input [7:0]S00_AXI_arlen;
  input [2:0]S00_AXI_arsize;
  input [1:0]S00_AXI_arburst;
  input [0:0]S00_AXI_arlock;
  input [3:0]S00_AXI_arcache;
  input [2:0]S00_AXI_arprot;
  input [3:0]S00_AXI_arqos;
  input S00_AXI_arvalid;
  output S00_AXI_arready;
  output [31:0]S00_AXI_rdata;
  output [1:0]S00_AXI_rresp;
  output S00_AXI_rlast;
  output S00_AXI_rvalid;
  input S00_AXI_rready;
  input [31:0]S01_AXI_awaddr;
  input [7:0]S01_AXI_awlen;
  input [2:0]S01_AXI_awsize;
  input [1:0]S01_AXI_awburst;
  input [0:0]S01_AXI_awlock;
  input [3:0]S01_AXI_awcache;
  input [2:0]S01_AXI_awprot;
  input [3:0]S01_AXI_awqos;
  input S01_AXI_awvalid;
  output S01_AXI_awready;
  input [31:0]S01_AXI_wdata;
  input [3:0]S01_AXI_wstrb;
  input S01_AXI_wlast;
  input S01_AXI_wvalid;
  output S01_AXI_wready;
  output [1:0]S01_AXI_bresp;
  output S01_AXI_bvalid;
  input S01_AXI_bready;
  output [31:0]M00_AXI_awaddr;
  output [3:0]M00_AXI_awlen;
  output [2:0]M00_AXI_awsize;
  output [1:0]M00_AXI_awburst;
  output [1:0]M00_AXI_awlock;
  output [3:0]M00_AXI_awcache;
  output [2:0]M00_AXI_awprot;
  output [3:0]M00_AXI_awqos;
  output M00_AXI_awvalid;
  input M00_AXI_awready;
  output [63:0]M00_AXI_wdata;
  output [7:0]M00_AXI_wstrb;
  output M00_AXI_wlast;
  output M00_AXI_wvalid;
  input M00_AXI_wready;
  input [1:0]M00_AXI_bresp;
  input M00_AXI_bvalid;
  output M00_AXI_bready;
  output [31:0]M00_AXI_araddr;
  output [3:0]M00_AXI_arlen;
  output [2:0]M00_AXI_arsize;
  output [1:0]M00_AXI_arburst;
  output [1:0]M00_AXI_arlock;
  output [3:0]M00_AXI_arcache;
  output [2:0]M00_AXI_arprot;
  output [3:0]M00_AXI_arqos;
  output M00_AXI_arvalid;
  input M00_AXI_arready;
  input [63:0]M00_AXI_rdata;
  input [1:0]M00_AXI_rresp;
  input M00_AXI_rlast;
  input M00_AXI_rvalid;
  output M00_AXI_rready;
endmodule
