EslamWaleed79/-FPGA-Based-Edge-AI-Vision-_Accelerator/Vivado_____Files/Run1/project_3.cache/ip/2018.2/834a266d3c0b1bb2/design_1_axi_smc_0_stub.vhdl

-- Copyright 1986-2018 Xilinx, Inc. All Rights Reserved.
-- --------------------------------------------------------------------------------
-- Tool Version: Vivado v.2018.2 (win64) Build 2258646 Thu Jun 14 20:03:12 MDT 2018
-- Date        : Thu Sep 10 13:42:07 2026
-- Host        : DESKTOP-1IDCUPR running 64-bit major release  (build 9200)
-- Command     : write_vhdl -force -mode synth_stub -rename_top decalper_eb_ot_sdeen_pot_pi_dehcac_xnilix -prefix
--               decalper_eb_ot_sdeen_pot_pi_dehcac_xnilix_ design_1_axi_smc_0_stub.vhdl
-- Design      : design_1_axi_smc_0
-- Purpose     : Stub declaration of top-level module interface
-- Device      : xc7z020clg400-1
-- --------------------------------------------------------------------------------
library IEEE;
use IEEE.STD_LOGIC_1164.ALL;

entity decalper_eb_ot_sdeen_pot_pi_dehcac_xnilix is
  Port ( 
    aclk : in STD_LOGIC;
    aresetn : in STD_LOGIC;
    S00_AXI_araddr : in STD_LOGIC_VECTOR ( 31 downto 0 );
    S00_AXI_arlen : in STD_LOGIC_VECTOR ( 7 downto 0 );
    S00_AXI_arsize : in STD_LOGIC_VECTOR ( 2 downto 0 );
    S00_AXI_arburst : in STD_LOGIC_VECTOR ( 1 downto 0 );
    S00_AXI_arlock : in STD_LOGIC_VECTOR ( 0 to 0 );
    S00_AXI_arcache : in STD_LOGIC_VECTOR ( 3 downto 0 );
    S00_AXI_arprot : in STD_LOGIC_VECTOR ( 2 downto 0 );
    S00_AXI_arqos : in STD_LOGIC_VECTOR ( 3 downto 0 );
    S00_AXI_arvalid : in STD_LOGIC;
    S00_AXI_arready : out STD_LOGIC;
    S00_AXI_rdata : out STD_LOGIC_VECTOR ( 31 downto 0 );
    S00_AXI_rresp : out STD_LOGIC_VECTOR ( 1 downto 0 );
    S00_AXI_rlast : out STD_LOGIC;
    S00_AXI_rvalid : out STD_LOGIC;
    S00_AXI_rready : in STD_LOGIC;
    S01_AXI_awaddr : in STD_LOGIC_VECTOR ( 31 downto 0 );
    S01_AXI_awlen : in STD_LOGIC_VECTOR ( 7 downto 0 );
    S01_AXI_awsize : in STD_LOGIC_VECTOR ( 2 downto 0 );
    S01_AXI_awburst : in STD_LOGIC_VECTOR ( 1 downto 0 );
    S01_AXI_awlock : in STD_LOGIC_VECTOR ( 0 to 0 );
    S01_AXI_awcache : in STD_LOGIC_VECTOR ( 3 downto 0 );
    S01_AXI_awprot : in STD_LOGIC_VECTOR ( 2 downto 0 );
    S01_AXI_awqos : in STD_LOGIC_VECTOR ( 3 downto 0 );
    S01_AXI_awvalid : in STD_LOGIC;
    S01_AXI_awready : out STD_LOGIC;
    S01_AXI_wdata : in STD_LOGIC_VECTOR ( 31 downto 0 );
    S01_AXI_wstrb : in STD_LOGIC_VECTOR ( 3 downto 0 );
    S01_AXI_wlast : in STD_LOGIC;
    S01_AXI_wvalid : in STD_LOGIC;
    S01_AXI_wready : out STD_LOGIC;
    S01_AXI_bresp : out STD_LOGIC_VECTOR ( 1 downto 0 );
    S01_AXI_bvalid : out STD_LOGIC;
    S01_AXI_bready : in STD_LOGIC;
    M00_AXI_awaddr : out STD_LOGIC_VECTOR ( 31 downto 0 );
    M00_AXI_awlen : out STD_LOGIC_VECTOR ( 3 downto 0 );
    M00_AXI_awsize : out STD_LOGIC_VECTOR ( 2 downto 0 );
    M00_AXI_awburst : out STD_LOGIC_VECTOR ( 1 downto 0 );
    M00_AXI_awlock : out STD_LOGIC_VECTOR ( 1 downto 0 );
    M00_AXI_awcache : out STD_LOGIC_VECTOR ( 3 downto 0 );
    M00_AXI_awprot : out STD_LOGIC_VECTOR ( 2 downto 0 );
    M00_AXI_awqos : out STD_LOGIC_VECTOR ( 3 downto 0 );
    M00_AXI_awvalid : out STD_LOGIC;
    M00_AXI_awready : in STD_LOGIC;
    M00_AXI_wdata : out STD_LOGIC_VECTOR ( 63 downto 0 );
    M00_AXI_wstrb : out STD_LOGIC_VECTOR ( 7 downto 0 );
    M00_AXI_wlast : out STD_LOGIC;
    M00_AXI_wvalid : out STD_LOGIC;
    M00_AXI_wready : in STD_LOGIC;
    M00_AXI_bresp : in STD_LOGIC_VECTOR ( 1 downto 0 );
    M00_AXI_bvalid : in STD_LOGIC;
    M00_AXI_bready : out STD_LOGIC;
    M00_AXI_araddr : out STD_LOGIC_VECTOR ( 31 downto 0 );
    M00_AXI_arlen : out STD_LOGIC_VECTOR ( 3 downto 0 );
    M00_AXI_arsize : out STD_LOGIC_VECTOR ( 2 downto 0 );
    M00_AXI_arburst : out STD_LOGIC_VECTOR ( 1 downto 0 );
    M00_AXI_arlock : out STD_LOGIC_VECTOR ( 1 downto 0 );
    M00_AXI_arcache : out STD_LOGIC_VECTOR ( 3 downto 0 );
    M00_AXI_arprot : out STD_LOGIC_VECTOR ( 2 downto 0 );
    M00_AXI_arqos : out STD_LOGIC_VECTOR ( 3 downto 0 );
    M00_AXI_arvalid : out STD_LOGIC;
    M00_AXI_arready : in STD_LOGIC;
    M00_AXI_rdata : in STD_LOGIC_VECTOR ( 63 downto 0 );
    M00_AXI_rresp : in STD_LOGIC_VECTOR ( 1 downto 0 );
    M00_AXI_rlast : in STD_LOGIC;
    M00_AXI_rvalid : in STD_LOGIC;
    M00_AXI_rready : out STD_LOGIC
  );

end decalper_eb_ot_sdeen_pot_pi_dehcac_xnilix;

architecture stub of decalper_eb_ot_sdeen_pot_pi_dehcac_xnilix is
attribute syn_black_box : boolean;
attribute black_box_pad_pin : string;
attribute syn_black_box of stub : architecture is true;
attribute black_box_pad_pin of stub : architecture is "aclk,aresetn,S00_AXI_araddr[31:0],S00_AXI_arlen[7:0],S00_AXI_arsize[2:0],S00_AXI_arburst[1:0],S00_AXI_arlock[0:0],S00_AXI_arcache[3:0],S00_AXI_arprot[2:0],S00_AXI_arqos[3:0],S00_AXI_arvalid,S00_AXI_arready,S00_AXI_rdata[31:0],S00_AXI_rresp[1:0],S00_AXI_rlast,S00_AXI_rvalid,S00_AXI_rready,S01_AXI_awaddr[31:0],S01_AXI_awlen[7:0],S01_AXI_awsize[2:0],S01_AXI_awburst[1:0],S01_AXI_awlock[0:0],S01_AXI_awcache[3:0],S01_AXI_awprot[2:0],S01_AXI_awqos[3:0],S01_AXI_awvalid,S01_AXI_awready,S01_AXI_wdata[31:0],S01_AXI_wstrb[3:0],S01_AXI_wlast,S01_AXI_wvalid,S01_AXI_wready,S01_AXI_bresp[1:0],S01_AXI_bvalid,S01_AXI_bready,M00_AXI_awaddr[31:0],M00_AXI_awlen[3:0],M00_AXI_awsize[2:0],M00_AXI_awburst[1:0],M00_AXI_awlock[1:0],M00_AXI_awcache[3:0],M00_AXI_awprot[2:0],M00_AXI_awqos[3:0],M00_AXI_awvalid,M00_AXI_awready,M00_AXI_wdata[63:0],M00_AXI_wstrb[7:0],M00_AXI_wlast,M00_AXI_wvalid,M00_AXI_wready,M00_AXI_bresp[1:0],M00_AXI_bvalid,M00_AXI_bready,M00_AXI_araddr[31:0],M00_AXI_arlen[3:0],M00_AXI_arsize[2:0],M00_AXI_arburst[1:0],M00_AXI_arlock[1:0],M00_AXI_arcache[3:0],M00_AXI_arprot[2:0],M00_AXI_arqos[3:0],M00_AXI_arvalid,M00_AXI_arready,M00_AXI_rdata[63:0],M00_AXI_rresp[1:0],M00_AXI_rlast,M00_AXI_rvalid,M00_AXI_rready";
attribute X_CORE_INFO : string;
attribute X_CORE_INFO of stub : architecture is "bd_afc3,Vivado 2018.2";
begin
end;
