EslamWaleed79/-FPGA-Based-Edge-AI-Vision-_Accelerator/Vivado_____Files/Run1/project_3.srcs/sources_1/bd/design_1/ip/design_1_rst_ps7_0_50M_0/design_1_rst_ps7_0_50M_0_stub.vhdl

-- Copyright 1986-2018 Xilinx, Inc. All Rights Reserved.
-- --------------------------------------------------------------------------------
-- Tool Version: Vivado v.2018.2 (win64) Build 2258646 Thu Jun 14 20:03:12 MDT 2018
-- Date        : Thu Sep 10 00:17:58 2026
-- Host        : DESKTOP-1IDCUPR running 64-bit major release  (build 9200)
-- Command     : write_vhdl -force -mode synth_stub
--               C:/Users/compumarts/Desktop/project_3/project_3.srcs/sources_1/bd/design_1/ip/design_1_rst_ps7_0_50M_0/design_1_rst_ps7_0_50M_0_stub.vhdl
-- Design      : design_1_rst_ps7_0_50M_0
-- Purpose     : Stub declaration of top-level module interface
-- Device      : xc7z020clg400-1
-- --------------------------------------------------------------------------------
library IEEE;
use IEEE.STD_LOGIC_1164.ALL;

entity design_1_rst_ps7_0_50M_0 is
  Port ( 
    slowest_sync_clk : in STD_LOGIC;
    ext_reset_in : in STD_LOGIC;
    aux_reset_in : in STD_LOGIC;
    mb_debug_sys_rst : in STD_LOGIC;
    dcm_locked : in STD_LOGIC;
    mb_reset : out STD_LOGIC;
    bus_struct_reset : out STD_LOGIC_VECTOR ( 0 to 0 );
    peripheral_reset : out STD_LOGIC_VECTOR ( 0 to 0 );
    interconnect_aresetn : out STD_LOGIC_VECTOR ( 0 to 0 );
    peripheral_aresetn : out STD_LOGIC_VECTOR ( 0 to 0 )
  );

end design_1_rst_ps7_0_50M_0;

architecture stub of design_1_rst_ps7_0_50M_0 is
attribute syn_black_box : boolean;
attribute black_box_pad_pin : string;
attribute syn_black_box of stub : architecture is true;
attribute black_box_pad_pin of stub : architecture is "slowest_sync_clk,ext_reset_in,aux_reset_in,mb_debug_sys_rst,dcm_locked,mb_reset,bus_struct_reset[0:0],peripheral_reset[0:0],interconnect_aresetn[0:0],peripheral_aresetn[0:0]";
attribute x_core_info : string;
attribute x_core_info of stub : architecture is "proc_sys_reset,Vivado 2018.2";
begin
end;
