EslamWaleed79/-FPGA-Based-Edge-AI-Vision-_Accelerator/Vivado_____Files/Run1/project_3.cache/ip/2018.2/5e775ec5af7193b1/design_1_processing_system7_0_0_sim_netlist.vhdl

-- Copyright 1986-2018 Xilinx, Inc. All Rights Reserved.
-- --------------------------------------------------------------------------------
-- Tool Version: Vivado v.2018.2 (win64) Build 2258646 Thu Jun 14 20:03:12 MDT 2018
-- Date        : Thu Sep 10 00:08:28 2026
-- Host        : DESKTOP-1IDCUPR running 64-bit major release  (build 9200)
-- Command     : write_vhdl -force -mode funcsim -rename_top decalper_eb_ot_sdeen_pot_pi_dehcac_xnilix -prefix
--               decalper_eb_ot_sdeen_pot_pi_dehcac_xnilix_ design_1_processing_system7_0_0_sim_netlist.vhdl
-- Design      : design_1_processing_system7_0_0
-- Purpose     : This VHDL netlist is a functional simulation representation of the design and should not be modified or
--               synthesized. This netlist cannot be used for SDF annotated simulation.
-- Device      : xc7z020clg400-1
-- --------------------------------------------------------------------------------
library IEEE;
use IEEE.STD_LOGIC_1164.ALL;
library UNISIM;
use UNISIM.VCOMPONENTS.ALL;
entity decalper_eb_ot_sdeen_pot_pi_dehcac_xnilix_processing_system7_v5_5_processing_system7 is
  port (
    CAN0_PHY_TX : out STD_LOGIC;
    CAN0_PHY_RX : in STD_LOGIC;
    CAN1_PHY_TX : out STD_LOGIC;
    CAN1_PHY_RX : in STD_LOGIC;
    ENET0_GMII_TX_EN : out STD_LOGIC;
    ENET0_GMII_TX_ER : out STD_LOGIC;
    ENET0_MDIO_MDC : out STD_LOGIC;
    ENET0_MDIO_O : out STD_LOGIC;
    ENET0_MDIO_T : out STD_LOGIC;
    ENET0_PTP_DELAY_REQ_RX : out STD_LOGIC;
    ENET0_PTP_DELAY_REQ_TX : out STD_LOGIC;
    ENET0_PTP_PDELAY_REQ_RX : out STD_LOGIC;
    ENET0_PTP_PDELAY_REQ_TX : out STD_LOGIC;
    ENET0_PTP_PDELAY_RESP_RX : out STD_LOGIC;
    ENET0_PTP_PDELAY_RESP_TX : out STD_LOGIC;
    ENET0_PTP_SYNC_FRAME_RX : out STD_LOGIC;
    ENET0_PTP_SYNC_FRAME_TX : out STD_LOGIC;
    ENET0_SOF_RX : out STD_LOGIC;
    ENET0_SOF_TX : out STD_LOGIC;
    ENET0_GMII_TXD : out STD_LOGIC_VECTOR ( 7 downto 0 );
    ENET0_GMII_COL : in STD_LOGIC;
    ENET0_GMII_CRS : in STD_LOGIC;
    ENET0_GMII_RX_CLK : in STD_LOGIC;
    ENET0_GMII_RX_DV : in STD_LOGIC;
    ENET0_GMII_RX_ER : in STD_LOGIC;
    ENET0_GMII_TX_CLK : in STD_LOGIC;
    ENET0_MDIO_I : in STD_LOGIC;
    ENET0_EXT_INTIN : in STD_LOGIC;
    ENET0_GMII_RXD : in STD_LOGIC_VECTOR ( 7 downto 0 );
    ENET1_GMII_TX_EN : out STD_LOGIC;
    ENET1_GMII_TX_ER : out STD_LOGIC;
    ENET1_MDIO_MDC : out STD_LOGIC;
    ENET1_MDIO_O : out STD_LOGIC;
    ENET1_MDIO_T : out STD_LOGIC;
    ENET1_PTP_DELAY_REQ_RX : out STD_LOGIC;
    ENET1_PTP_DELAY_REQ_TX : out STD_LOGIC;
    ENET1_PTP_PDELAY_REQ_RX : out STD_LOGIC;
    ENET1_PTP_PDELAY_REQ_TX : out STD_LOGIC;
    ENET1_PTP_PDELAY_RESP_RX : out STD_LOGIC;
    ENET1_PTP_PDELAY_RESP_TX : out STD_LOGIC;
    ENET1_PTP_SYNC_FRAME_RX : out STD_LOGIC;
    ENET1_PTP_SYNC_FRAME_TX : out STD_LOGIC;
    ENET1_SOF_RX : out STD_LOGIC;
    ENET1_SOF_TX : out STD_LOGIC;
    ENET1_GMII_TXD : out STD_LOGIC_VECTOR ( 7 downto 0 );
    ENET1_GMII_COL : in STD_LOGIC;
    ENET1_GMII_CRS : in STD_LOGIC;
    ENET1_GMII_RX_CLK : in STD_LOGIC;
    ENET1_GMII_RX_DV : in STD_LOGIC;
    ENET1_GMII_RX_ER : in STD_LOGIC;
    ENET1_GMII_TX_CLK : in STD_LOGIC;
    ENET1_MDIO_I : in STD_LOGIC;
    ENET1_EXT_INTIN : in STD_LOGIC;
    ENET1_GMII_RXD : in STD_LOGIC_VECTOR ( 7 downto 0 );
    GPIO_I : in STD_LOGIC_VECTOR ( 63 downto 0 );
    GPIO_O : out STD_LOGIC_VECTOR ( 63 downto 0 );
    GPIO_T : out STD_LOGIC_VECTOR ( 63 downto 0 );
    I2C0_SDA_I : in STD_LOGIC;
    I2C0_SDA_O : out STD_LOGIC;
    I2C0_SDA_T : out STD_LOGIC;
    I2C0_SCL_I : in STD_LOGIC;
    I2C0_SCL_O : out STD_LOGIC;
    I2C0_SCL_T : out STD_LOGIC;
    I2C1_SDA_I : in STD_LOGIC;
    I2C1_SDA_O : out STD_LOGIC;
    I2C1_SDA_T : out STD_LOGIC;
    I2C1_SCL_I : in STD_LOGIC;
    I2C1_SCL_O : out STD_LOGIC;
    I2C1_SCL_T : out STD_LOGIC;
    PJTAG_TCK : in STD_LOGIC;
    PJTAG_TMS : in STD_LOGIC;
    PJTAG_TDI : in STD_LOGIC;
    PJTAG_TDO : out STD_LOGIC;
    SDIO0_CLK : out STD_LOGIC;
    SDIO0_CLK_FB : in STD_LOGIC;
    SDIO0_CMD_O : out STD_LOGIC;
    SDIO0_CMD_I : in STD_LOGIC;
    SDIO0_CMD_T : out STD_LOGIC;
    SDIO0_DATA_I : in STD_LOGIC_VECTOR ( 3 downto 0 );
    SDIO0_DATA_O : out STD_LOGIC_VECTOR ( 3 downto 0 );
    SDIO0_DATA_T : out STD_LOGIC_VECTOR ( 3 downto 0 );
    SDIO0_LED : out STD_LOGIC;
    SDIO0_CDN : in STD_LOGIC;
    SDIO0_WP : in STD_LOGIC;
    SDIO0_BUSPOW : out STD_LOGIC;
    SDIO0_BUSVOLT : out STD_LOGIC_VECTOR ( 2 downto 0 );
    SDIO1_CLK : out STD_LOGIC;
    SDIO1_CLK_FB : in STD_LOGIC;
    SDIO1_CMD_O : out STD_LOGIC;
    SDIO1_CMD_I : in STD_LOGIC;
    SDIO1_CMD_T : out STD_LOGIC;
    SDIO1_DATA_I : in STD_LOGIC_VECTOR ( 3 downto 0 );
    SDIO1_DATA_O : out STD_LOGIC_VECTOR ( 3 downto 0 );
    SDIO1_DATA_T : out STD_LOGIC_VECTOR ( 3 downto 0 );
    SDIO1_LED : out STD_LOGIC;
    SDIO1_CDN : in STD_LOGIC;
    SDIO1_WP : in STD_LOGIC;
    SDIO1_BUSPOW : out STD_LOGIC;
    SDIO1_BUSVOLT : out STD_LOGIC_VECTOR ( 2 downto 0 );
    SPI0_SCLK_I : in STD_LOGIC;
    SPI0_SCLK_O : out STD_LOGIC;
    SPI0_SCLK_T : out STD_LOGIC;
    SPI0_MOSI_I : in STD_LOGIC;
    SPI0_MOSI_O : out STD_LOGIC;
    SPI0_MOSI_T : out STD_LOGIC;
    SPI0_MISO_I : in STD_LOGIC;
    SPI0_MISO_O : out STD_LOGIC;
    SPI0_MISO_T : out STD_LOGIC;
    SPI0_SS_I : in STD_LOGIC;
    SPI0_SS_O : out STD_LOGIC;
    SPI0_SS1_O : out STD_LOGIC;
    SPI0_SS2_O : out STD_LOGIC;
    SPI0_SS_T : out STD_LOGIC;
    SPI1_SCLK_I : in STD_LOGIC;
    SPI1_SCLK_O : out STD_LOGIC;
    SPI1_SCLK_T : out STD_LOGIC;
    SPI1_MOSI_I : in STD_LOGIC;
    SPI1_MOSI_O : out STD_LOGIC;
    SPI1_MOSI_T : out STD_LOGIC;
    SPI1_MISO_I : in STD_LOGIC;
    SPI1_MISO_O : out STD_LOGIC;
    SPI1_MISO_T : out STD_LOGIC;
    SPI1_SS_I : in STD_LOGIC;
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
