EslamWaleed79/-FPGA-Based-Edge-AI-Vision-_Accelerator/(commit log)

2026-09-08 Final Submission: Edge-AI Vision Accelerator RTL and Reports
    [config.txt, config_bank0.txt, config_bank1.txt, config_sobel.txt]
2026-09-12 Replace golden model text files and correct Sobel edge image
    [config_sobel.txt]
2026-09-12 Finalize repository structure and add Vivado files
    [config.txt, config_bank0.txt, config_bank1.txt]
